LesKaribous/Karibous-2024-Hardware/ECAD/MainBoard-2024/MainBoard-2024.png

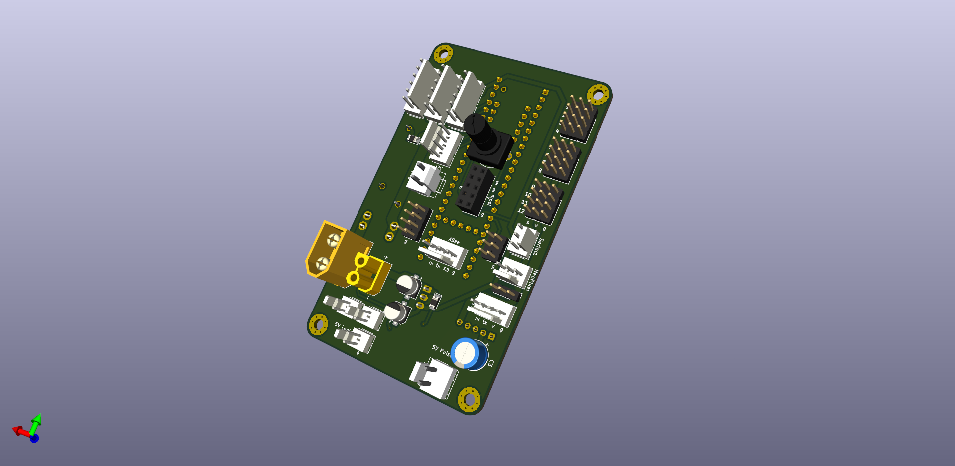
ECAD/MainBoard-2024/MainBoard-2024.png
