LesKaribous/Karibous-2024-Hardware/README.md

# Karibous-2024-Hardware
Hardware du robot des Karibous pour la Coupe de Robotique (Eurobot) 2024
