LesKaribous/Karibous-2024-Hardware/ECAD/MainBoard-2024/Graphics/TopConnectorSilk.png

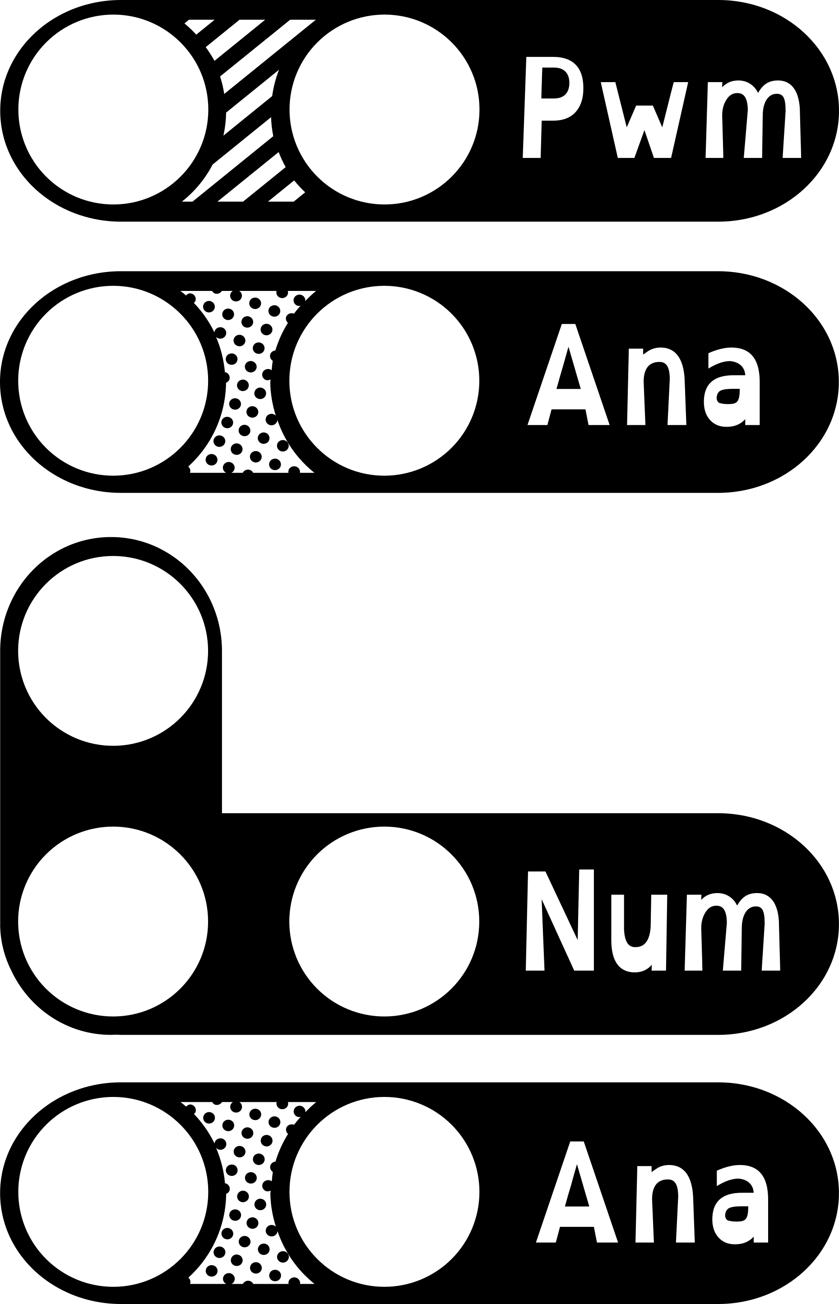
ECAD/MainBoard-2024/Graphics/TopConnectorSilk.png
