LesKaribous/Karibous-2024-Hardware/MCAD/table-parts/visuelDemiTable.png

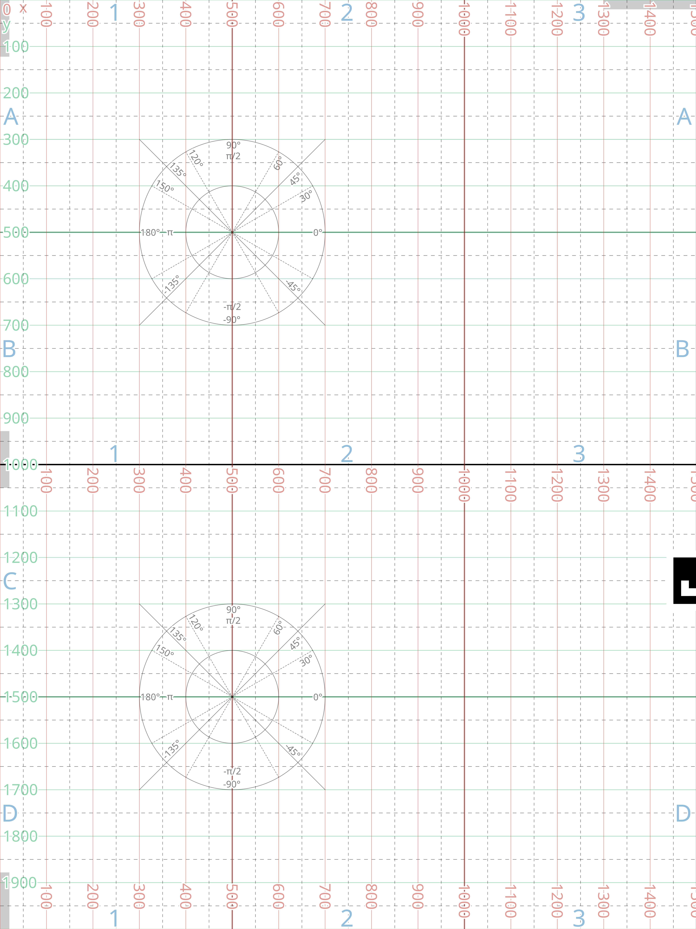
MCAD/table-parts/visuelDemiTable.png
