LesKaribous/Karibous-2024-Hardware/MCAD/table-parts/visuelTable.png

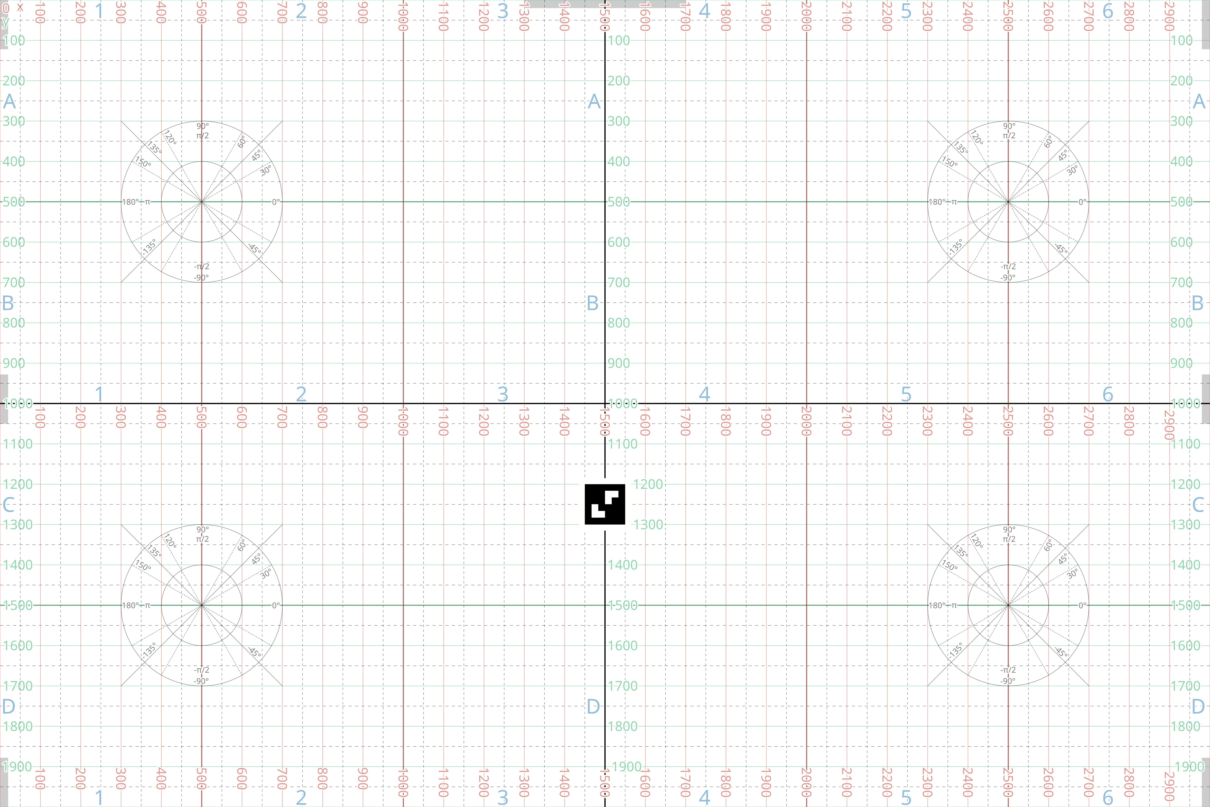
MCAD/table-parts/visuelTable.png
