LesKaribous/Karibous-2024-Hardware/MCAD/actuators-parts/main-actuator.FCStd

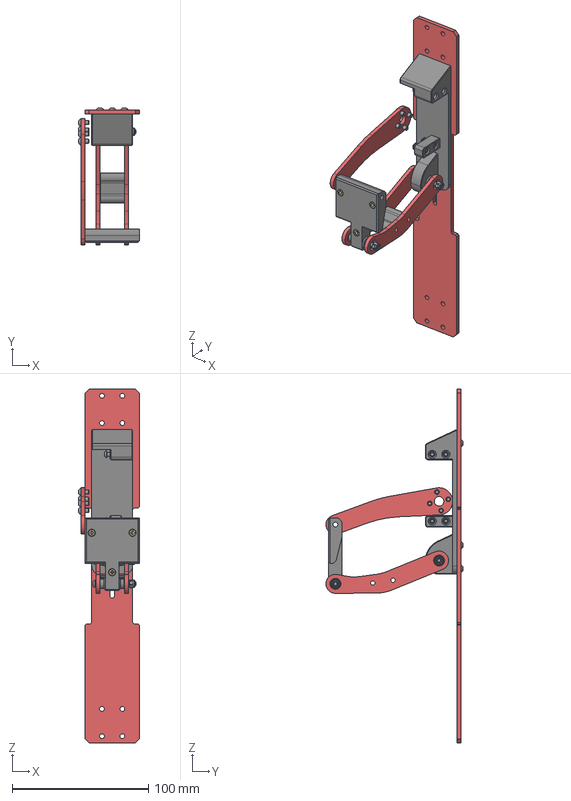
[picture p7: CAD file, 2024-04-19]
MCAD/actuators-parts/main-actuator.FCStd
44.7 x 100.8 x 260.0 mm
MainPlate
BrasInferieur x 2
M3x30-Vis x 2
M3x30-Vis001 x 2
M3-Écrou x 2
M3-Écrou001 x 2
InterBras
SupportPince
M3-Insert252 x 2
M3-Insert253 x 2
M3-Insert254 x 2
M3x6-Vis x 2
M3x6-Vis019 x 2
M3x6-Vis020 x 2
M3x6-Vis021 x 2
BrasServo
BerceauServo
M3x5.74-Insert x 2
M3x5.74-Insert260 x 2
M3x5.74-Insert261 x 2
M3x5.74-Insert262 x 2
M3x5.74-Insert263 x 2
M3x5.74-Insert264 x 2
M3x5.74-Insert265 x 2
M3x5.74-Insert266 x 2
M3x10-Vis x 2
M3x10-Vis584 x 2
M3x10-Vis585 x 2
M3x10-Vis586 x 2
M3x10-Vis599 x 2
M3x10-Vis600 x 2
M3x10-Vis601 x 2
M3x10-Vis602 x 2
