LesKaribous/Karibous-2024-Hardware/ECAD/Ihm-2024/footprints/3d/SW_PUSH-12mm.STEP

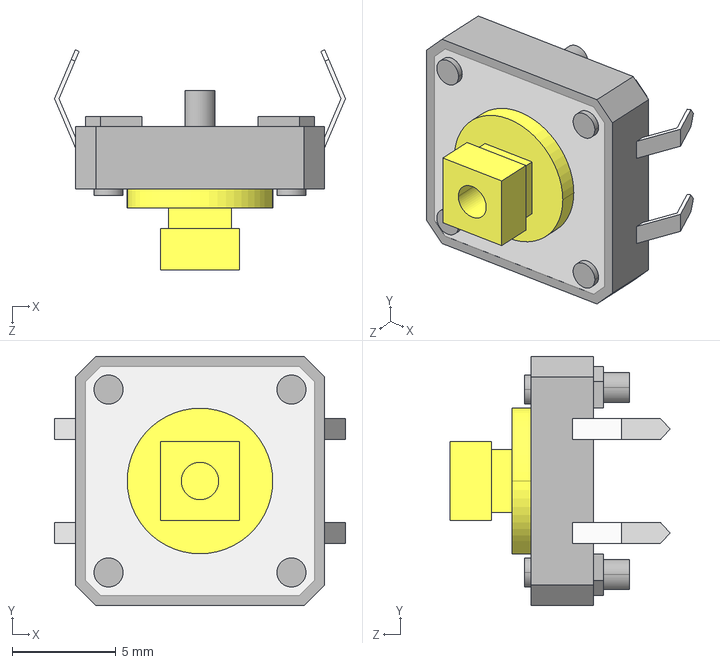
[picture p8: CAD file, 2023-06-12]
ECAD/Ihm-2024/footprints/3d/SW_PUSH-12mm.STEP
14.0 x 12.0 x 10.6 mm
