LesKaribous/Karibous-2024-Hardware/ECAD/MainBoard-2024/Graphics/TopConnectorSilk.dxf

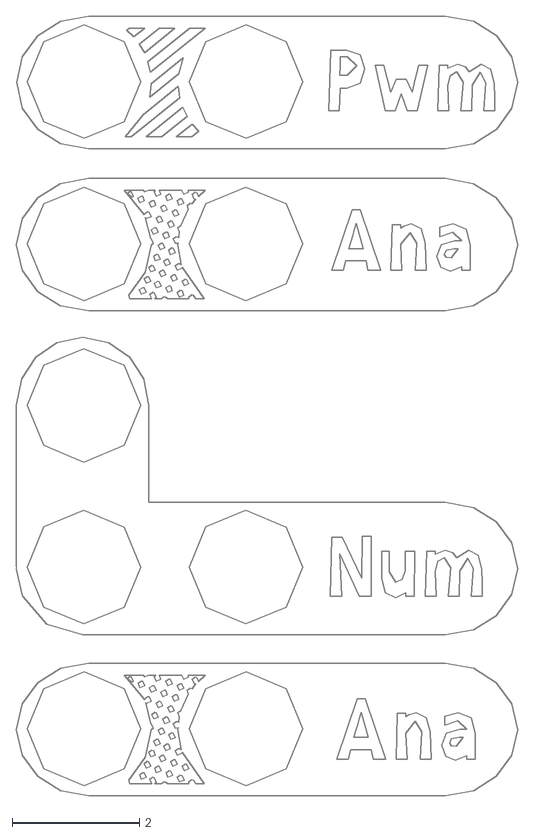
[picture p9: CAD file, 2023-05-28]
ECAD/MainBoard-2024/Graphics/TopConnectorSilk.dxf
7.87 x 12.2
