LesKaribous/Karibous-2024-Hardware/ECAD/MainBoard-2024/Librairies/3d/XT30_Female.stp

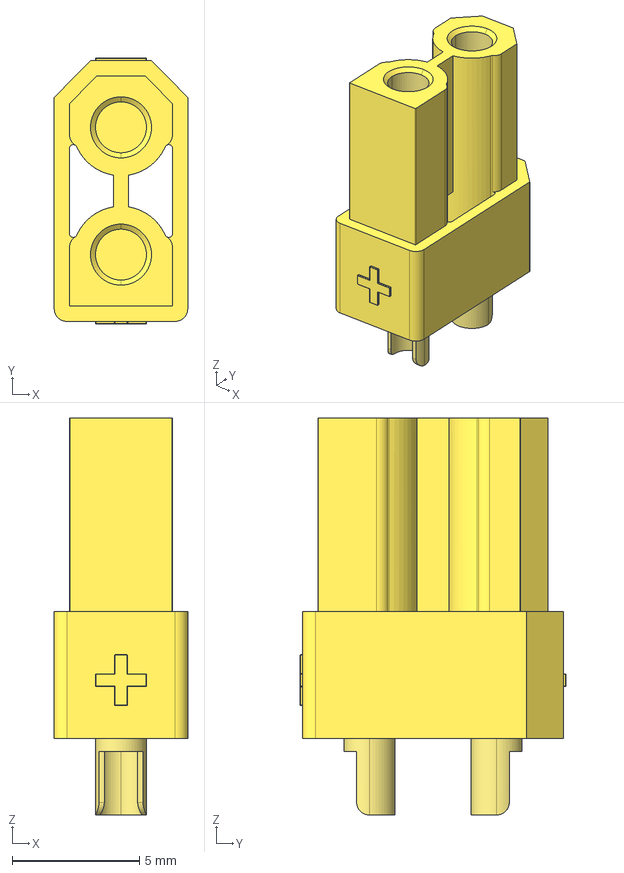
[picture p10: CAD file, 2023-05-28]
ECAD/MainBoard-2024/Librairies/3d/XT30_Female.stp
5.25 x 10.4 x 15.6 mm
