LesKaribous/Karibous-2024-Hardware/ECAD/MainBoard-2024/Librairies/TEN 50-2411/TEN_50-2411.step

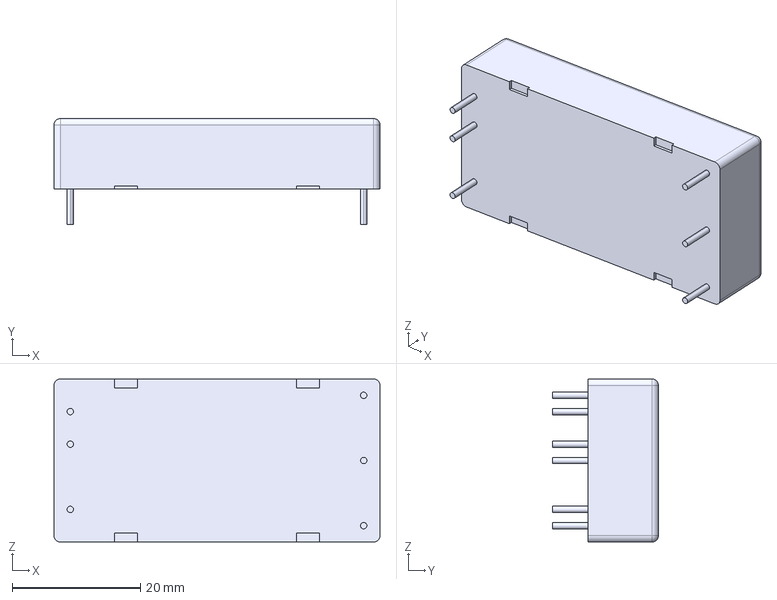
[picture p11: CAD file, 2023-05-28]
ECAD/MainBoard-2024/Librairies/TEN 50-2411/TEN_50-2411.step
50.8 x 16.5 x 25.4 mm
