LesKaribous/Karibous-2024-Hardware/MCAD/3d-print-special/BaliseCylindre.3mf

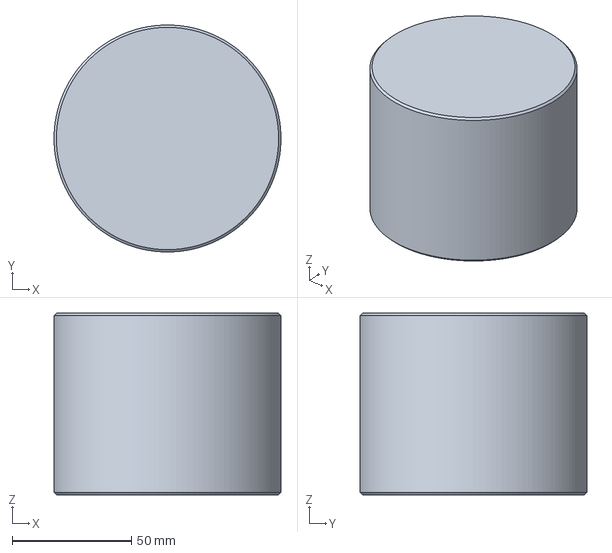
[picture p12: CAD file, 2024-05-01]
MCAD/3d-print-special/BaliseCylindre.3mf
95.0 x 95.0 x 76.0 mm
