LesKaribous/Karibous-2024-Hardware/MCAD/actuators-parts/solar-panel-actuator.FCStd

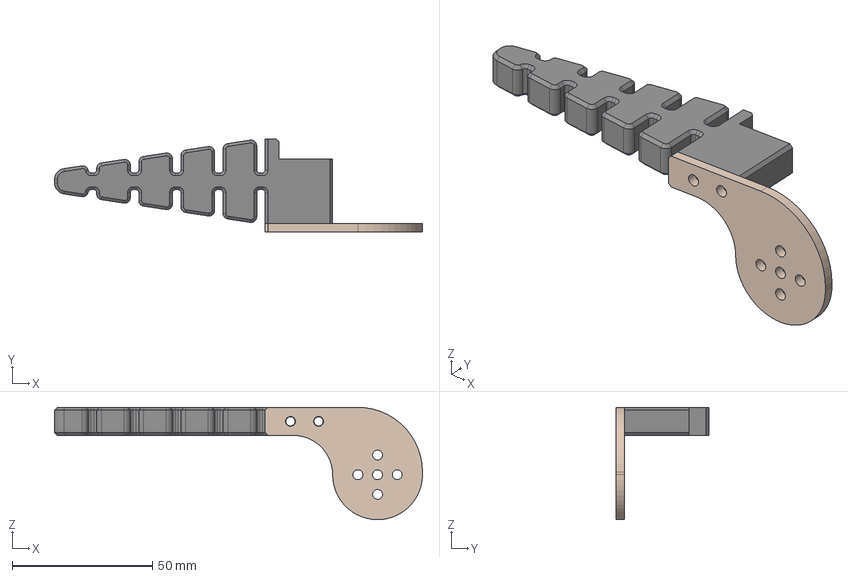
[picture p13: CAD file, 2024-05-04]
MCAD/actuators-parts/solar-panel-actuator.FCStd
131.0 x 33.0 x 40.0 mm
Plate
Finger
