LesKaribous/Karibous-2024-Hardware/MCAD/electronical-parts/deplacement-sensor.FCStd

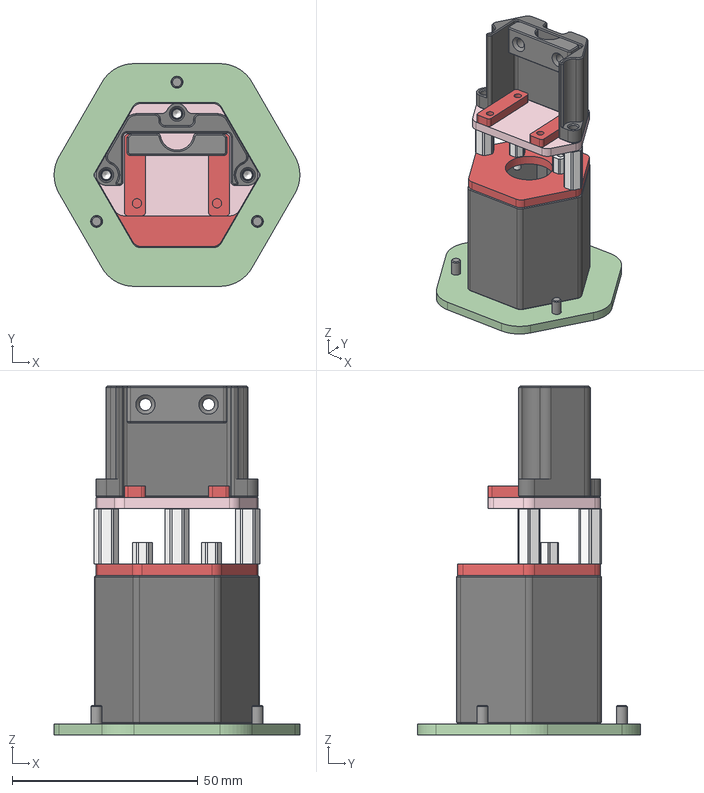
[picture p14: CAD file, 2024-05-06]
MCAD/electronical-parts/deplacement-sensor.FCStd
66.2 x 60.0 x 94.0 mm
SupportPCB
MainTube
FixingPlate
FixingPimori
M2.5x6xx5-Standoff x 2
M2.5x6xx5-Standoff001 x 2
M3x8-Screw x 2
M3x8-Screw039 x 2
M3x8-Screw040 x 2
M3x8-Screw041 x 2
M3x8-Screw042 x 2
M3x8-Screw043 x 2
M3x15xx6-Standoff x 2
M3x15xx6-Standoff013 x 2
M3x15xx6-Standoff014 x 2
FixingBNO055
SpacerBNO055
BrideCable
