LesKaribous/Karibous-2024-Hardware/MCAD/mechanical-parts/colonne-moteur.FCStd

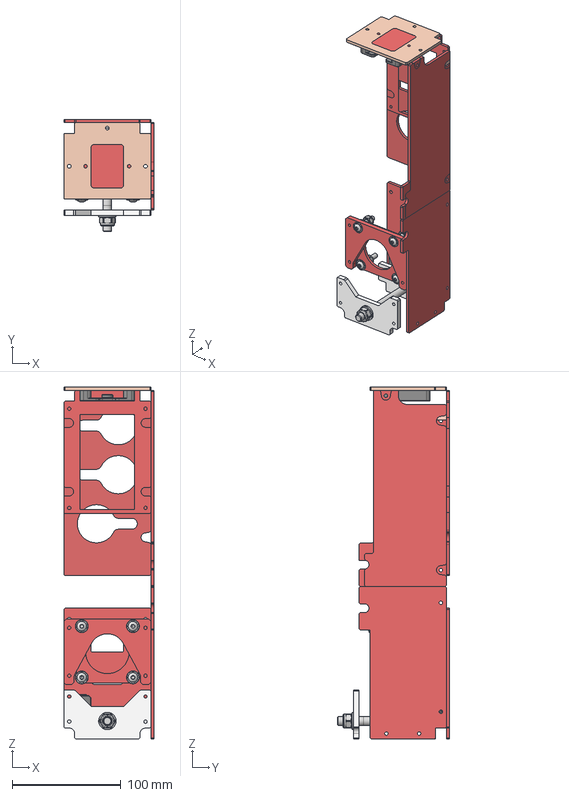
[picture p15: CAD file, 2024-05-06]
MCAD/mechanical-parts/colonne-moteur.FCStd
83.0 x 103.0 x 323.0 mm
CarterMoteur
PlaqueExterneSupportRoue
M8x90-Screw
RondelleLaser3mm
PlaqueInterneSupportRoue
M8-Nut
M8-Washer
SupportMoteur3mm
M5x25-Screw036
M6-Nut
M6-Nut013
M5x25-Screw
M5x25-Screw037
M5x25-Screw038
M6-Nut014
M6-Nut015
SupportMoteur5mm
SupportPololuPOL4079
CarterSup
CarterInf
CarterTop
CarterSide240*320
CarterSupRapid
CarterSupRapideCables
CarterTopXBee
SupportXBee
CarterSupCoteServo
