LesKaribous/Karibous-2024-Hardware/MCAD/robot_holonome.FCStd

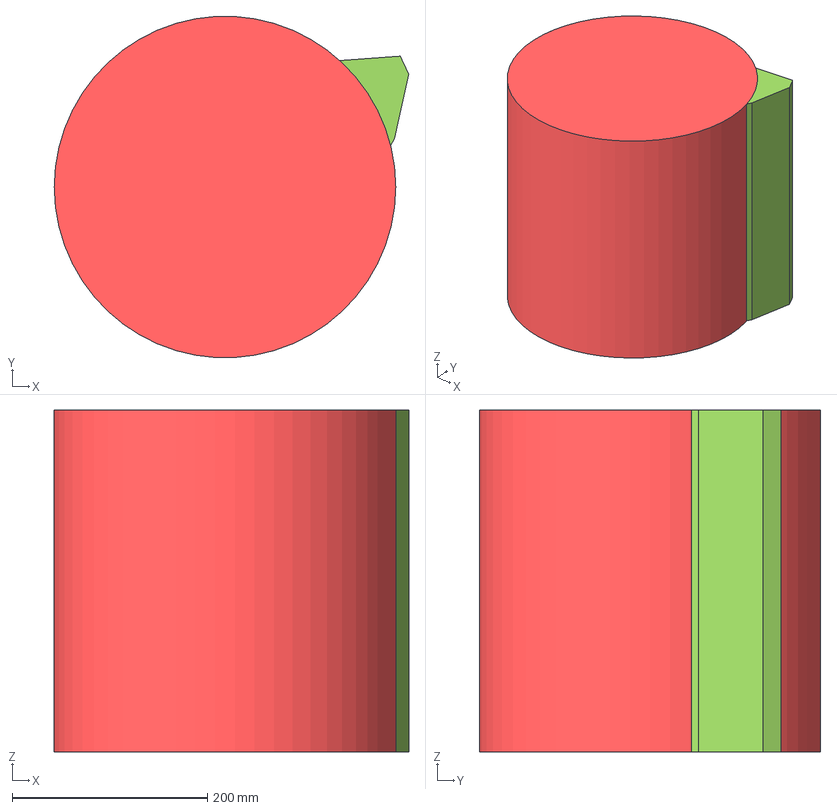
[picture p16: CAD file, 2024-05-06]
MCAD/robot_holonome.FCStd
363.3 x 349.4 x 350.0 mm
Limite Non Déployé
Limite Déployé
Perimètre Déployé
