LesKaribous/Karibous-2024-Hardware/MCAD/table-parts/CoteJardiniere.FCStd

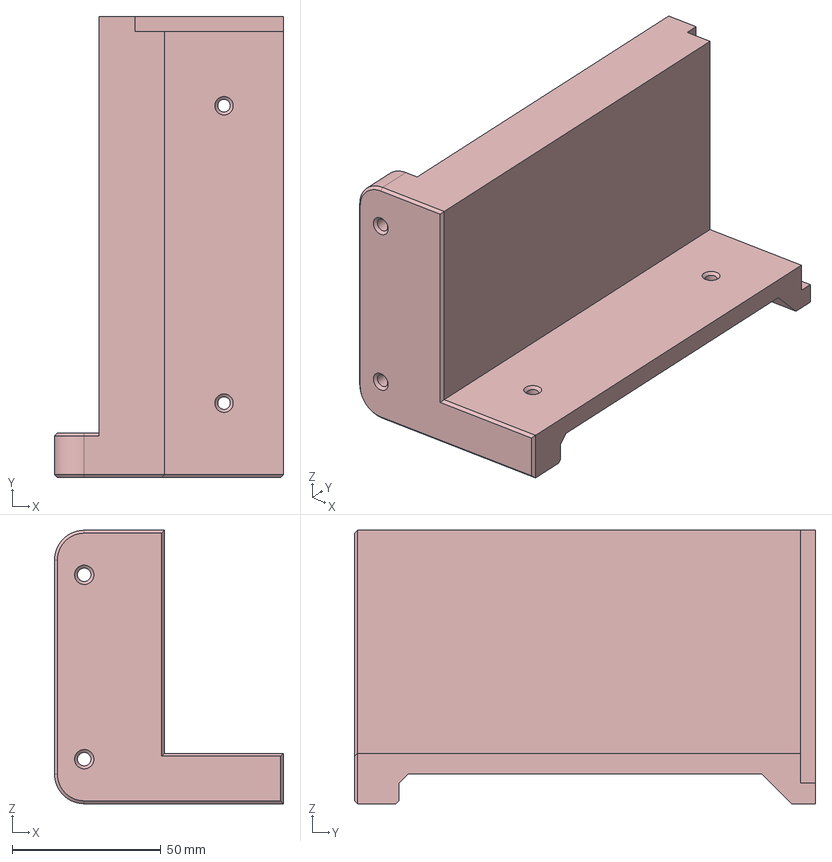
[picture p17: CAD file, 2024-03-27]
MCAD/table-parts/CoteJardiniere.FCStd
77.0 x 155.0 x 92.0 mm
