LesKaribous/Karibous-2024-Hardware/ECAD/Ihm-2024/footprints/3d/SK-12D10.FCStd

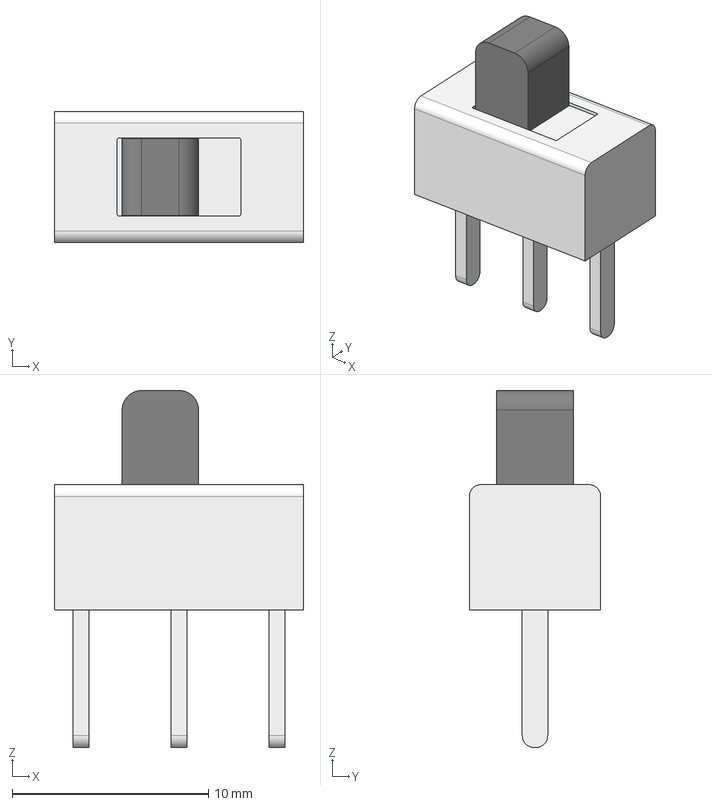
[picture p18: CAD file, 2023-06-12]
ECAD/Ihm-2024/footprints/3d/SK-12D10.FCStd
12.7 x 6.70 x 18.2 mm
Pin
Lever
