LesKaribous/Karibous-2024-Hardware/MCAD/3d-print-special/BaliseHexagone.3mf

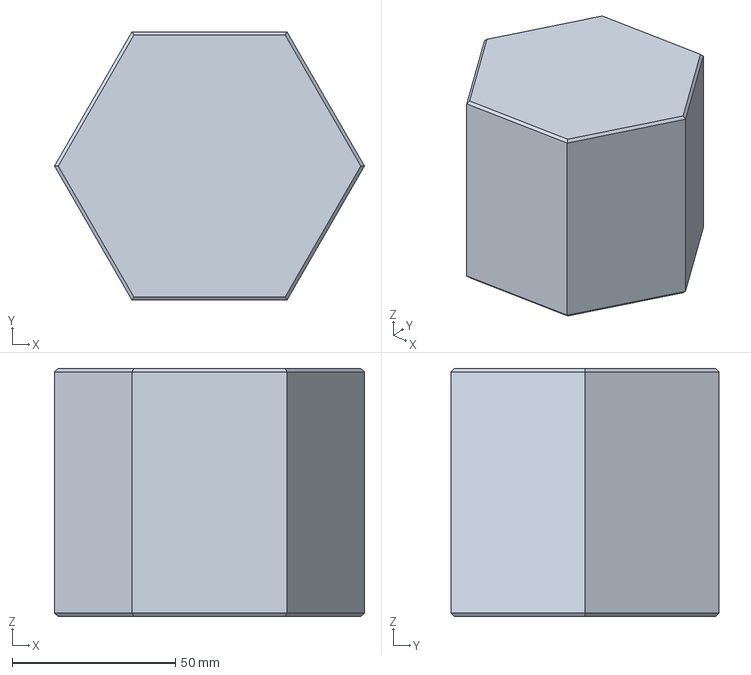
[picture p19: CAD file, 2024-05-01]
MCAD/3d-print-special/BaliseHexagone.3mf
95.0 x 82.3 x 76.0 mm
