LesKaribous/Karibous-2024-Hardware/MCAD/electronical-parts/tiroir_servo.FCStd

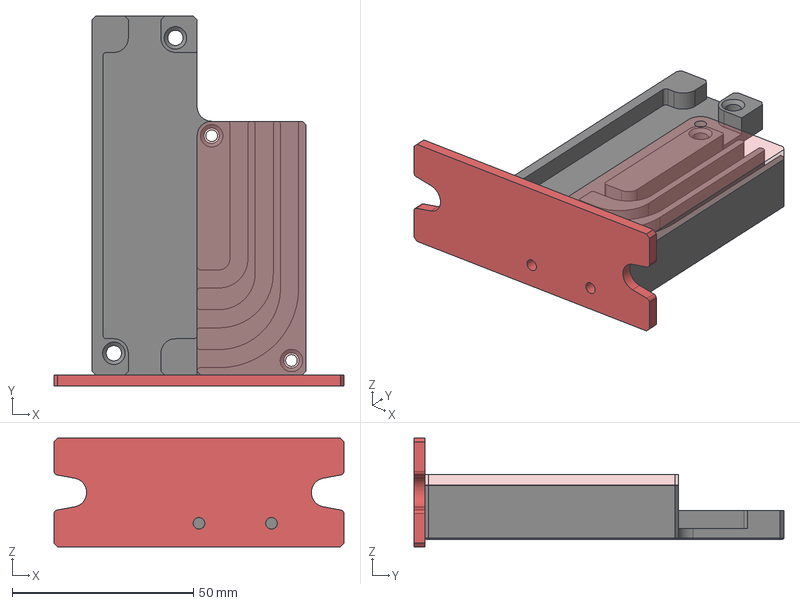
[picture p20: CAD file, 2024-01-14]
MCAD/electronical-parts/tiroir_servo.FCStd
80.0 x 102.0 x 30.0 mm
SupportCarte
FrontServo
CapotServo
