LesKaribous/Karibous-2024-Hardware/MCAD/mechanical-parts/structures.FCStd

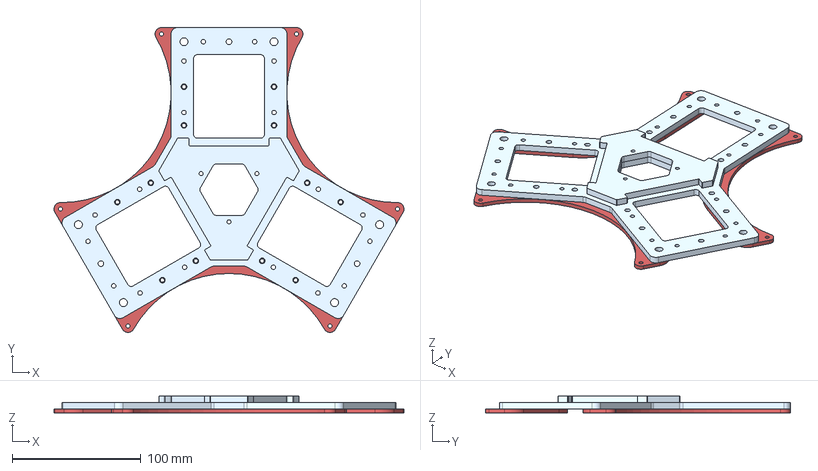
[picture p21: CAD file, 2024-05-06]
MCAD/mechanical-parts/structures.FCStd
272.1 x 237.0 x 13.0 mm
Semelle
CaleCentrale
PlaqueRoulement x 3
