LesKaribous/Karibous-2024-Hardware/MCAD/3d-print-special/BaliseCarre.3mf

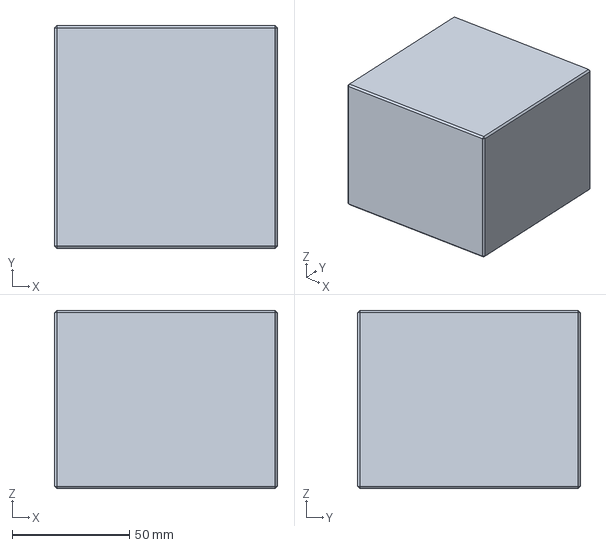
[picture p22: CAD file, 2024-05-01]
MCAD/3d-print-special/BaliseCarre.3mf
95.0 x 95.0 x 76.0 mm
