LesKaribous/Karibous-2024-Hardware/MCAD/actuators-parts/fork-actuator.FCStd

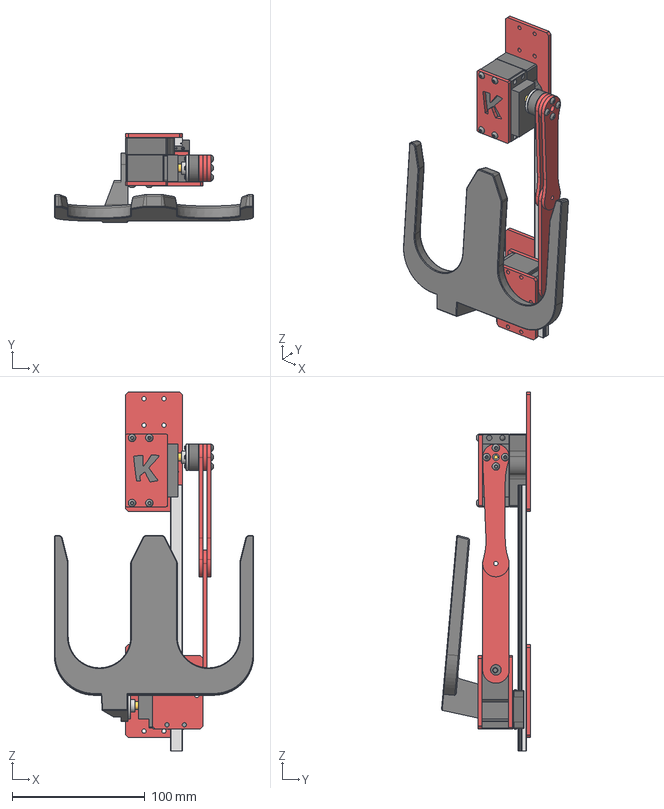
[picture p23: CAD file, 2024-04-19]
MCAD/actuators-parts/fork-actuator.FCStd
150.0 x 66.9 x 270.0 mm
TopArm1 x 2
SpacerArm
TopArm003
SpacerArm1
M3x20-Screw
M3x20-Screw001
M3x20-Screw002
M3x20-Screw003
BlocServo90° x 4
SpacerServo
PlateDeco
M3x10-Screw009 x 2
M3x10-Screw010 x 2
M3x10-Screw011 x 2
M3x10-Screw012 x 2
BottomCarter
TopCarter
RailBody
ServoPalonnier x 2
ServoBody001 x 2
ServoAxis001 x 2
PlaqueGuideCable
InterPlaque5
PlatineSlider
Slider
SupportAxe
Fork
