LesKaribous/Karibous-2024-Hardware/MCAD/mechanical-parts/balises.FCStd

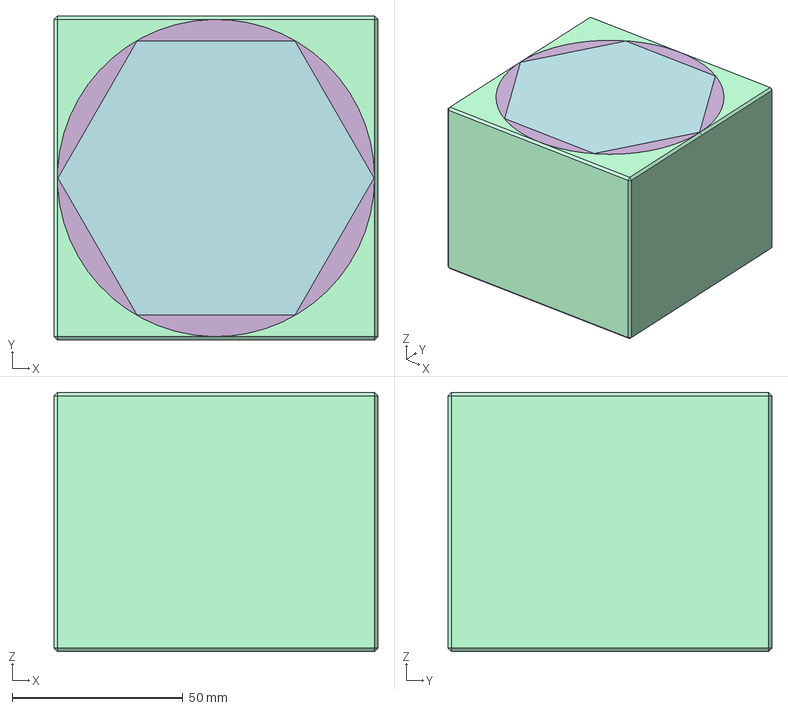
[picture p24: CAD file, 2024-05-01]
MCAD/mechanical-parts/balises.FCStd
95.0 x 95.0 x 76.0 mm
BaliseCarre
BaliseHexagone
BaliseCylindre
