LesKaribous/Karibous-2024-Hardware/MCAD/table_2024.FCStd

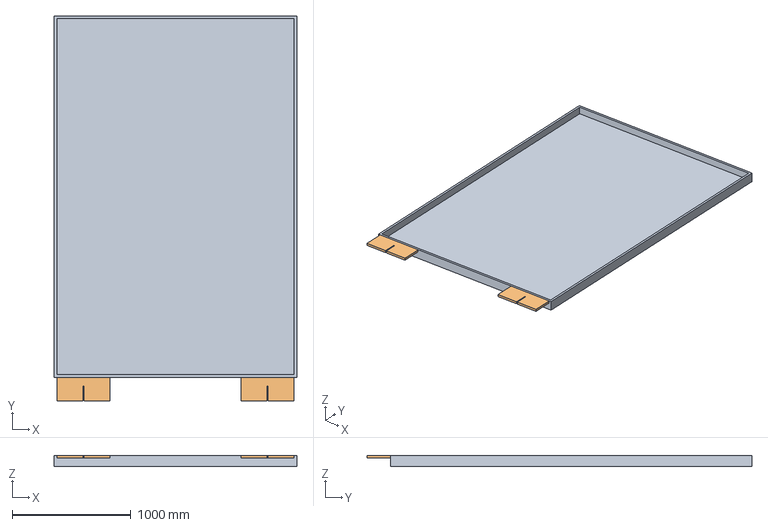
[picture p25: CAD file, 2023-09-15]
MCAD/table_2024.FCStd
2044.0 x 3244.0 x 92.0 mm
BaseTable
SupportVert x 2
