LesKaribous/Karibous-2024-Hardware/MCAD/mechanical-parts/omniwheel.FCStd

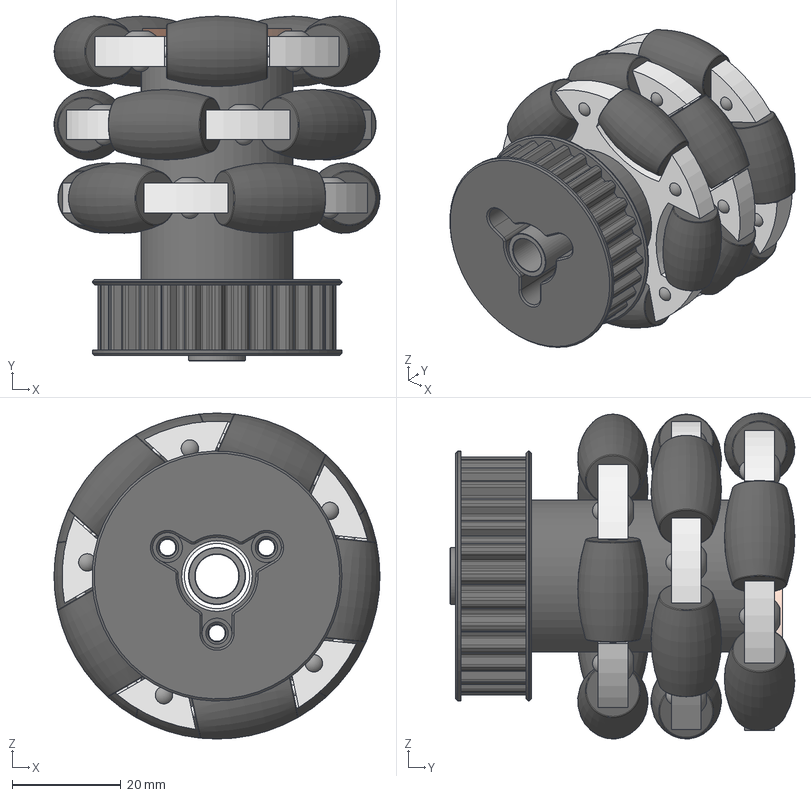
[picture p27: CAD file, 2023-11-20]
MCAD/mechanical-parts/omniwheel.FCStd
60.0 x 63.4 x 60.0 mm
Plate
MainPlate x 3
Roller x 15
Rivet x 15
Spacer001 x 2
Pulley001
Bague 8x10mm
