LesKaribous/Karibous-2024-Hardware/MCAD/actuators-parts/finger-filaflex.FCStd

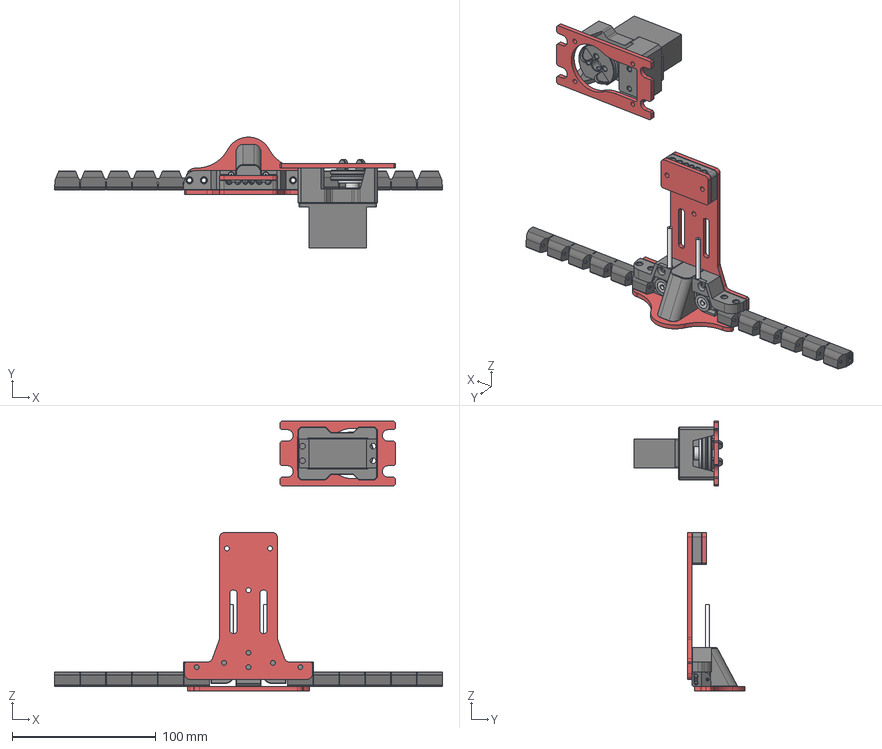
[picture p28: CAD file, 2024-02-26]
MCAD/actuators-parts/finger-filaflex.FCStd
269.6 x 77.0 x 187.5 mm
ServoBody001
ServoAxis001
SupportServo
CliptubeServo
PlaqueServo
ServoPalonnier
Poulie
FingerLeft
SupportFingerLeft
V623ZZ-intern x 2
V623ZZ-extern x 2
ClipTubeLeft
Tube-1ID-3OD x 2
FingerRight
SupportfingerRight
CliptubeRight
SupportCentral
PlaqueCentrale
PlaqueSupport
GestionnaireTube
PlaqueClipGestionnaire
