LesKaribous/Karibous-2024-Hardware/MCAD/mechanical-parts/generic-hardware.FCStd

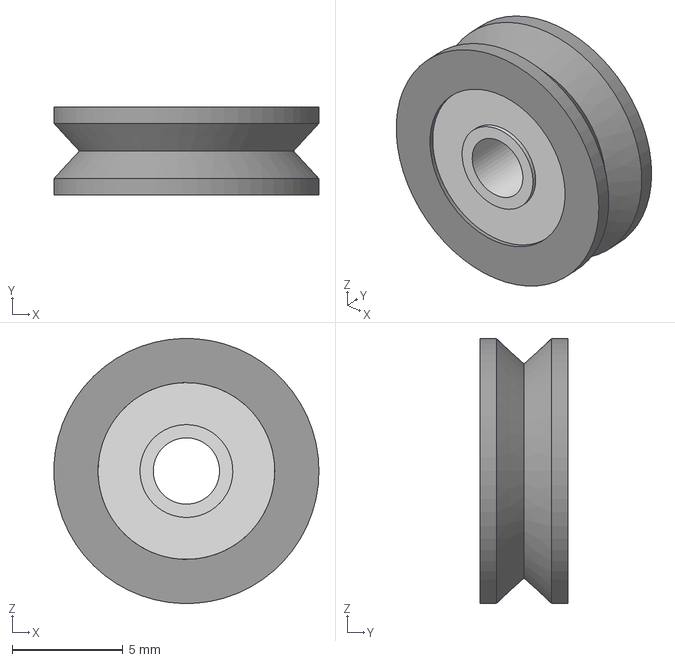
[picture p29: CAD file, 2023-11-20]
MCAD/mechanical-parts/generic-hardware.FCStd
12.0 x 4.00 x 12.0 mm
V623ZZ-intern
V623ZZ-extern
