LesKaribous/Karibous-2024-Hardware/MCAD/actuators-parts/finger-gripper.FCStd

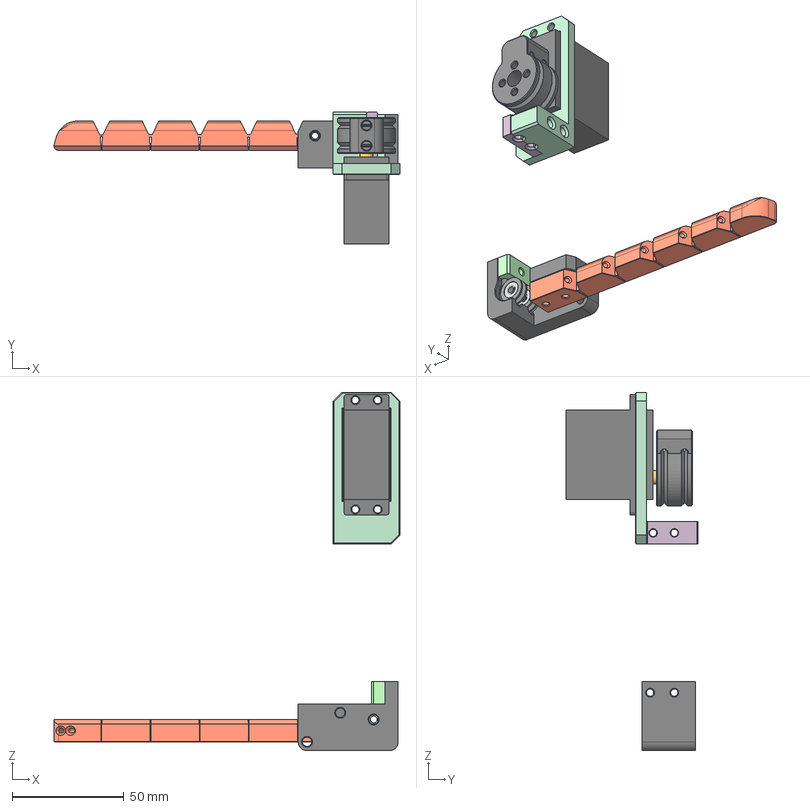
[picture p30: CAD file, 2024-01-02]
MCAD/actuators-parts/finger-gripper.FCStd
155.0 x 59.0 x 160.6 mm
ServoPalonnier
ServoBody001
ServoAxis001
PoulieMoteur
SupportTube
BrideSupportTube
FingerLeft
SupportPoulies
V623ZZ-intern x 2
V623ZZ-extern x 2
Bride
