LesKaribous/Karibous-2024-Hardware/MCAD/mechanical-parts/tools.FCStd

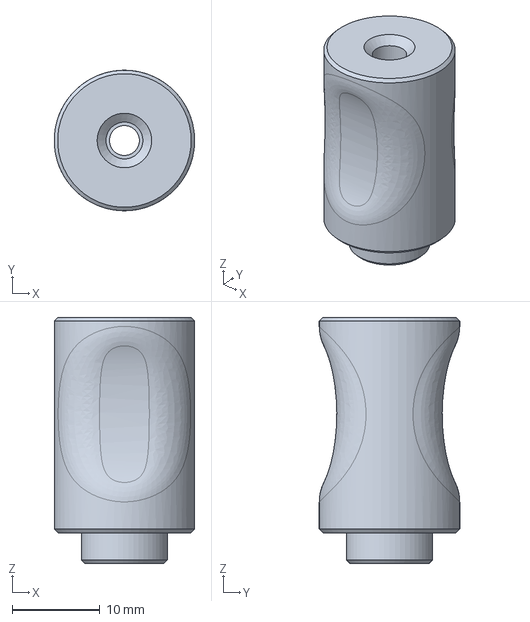
[picture p31: CAD file, 2023-05-29]
MCAD/mechanical-parts/tools.FCStd
16.0 x 16.0 x 28.0 mm
