LesKaribous/Karibous-2024-Hardware/(list of files, cad)

Other CAD files:
ECAD/MainBoard-2024/Librairies/TEN 50-2411/dimensions.FCStd
MCAD/robots_2024.FCStd
ECAD/Ihm-2024/footprints/3d/SK-12D10 1P2T.step
MCAD/actuators-parts/archives/main-actuator-brk.FCStd
