LesKaribous/Karibous-2024-Hardware/ECAD/SatelliteServo-2024/SatelliteServo-2024.kicad_pcb

## KiCad design ECAD/SatelliteServo-2024/SatelliteServo-2024.kicad_pcb (2024-05-09)

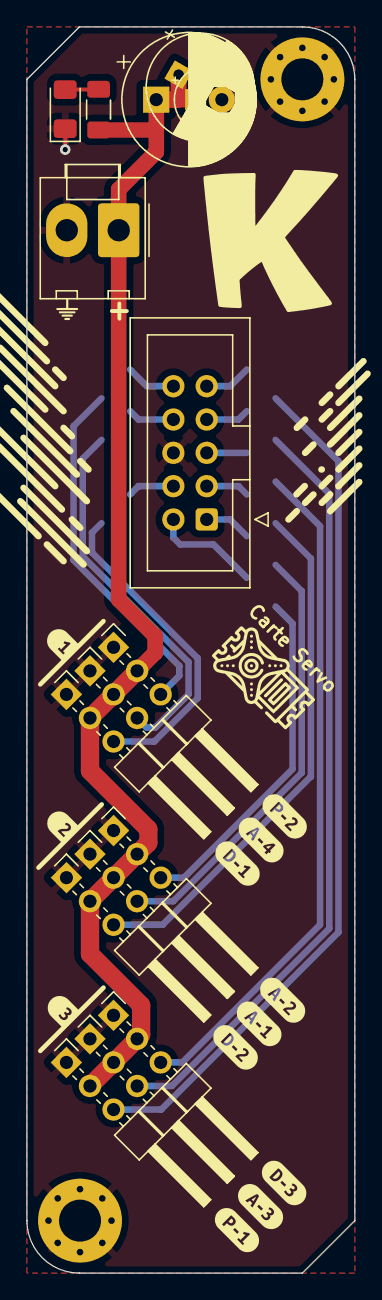
[picture p32: board SatelliteServo-2024.kicad_pcb from above]

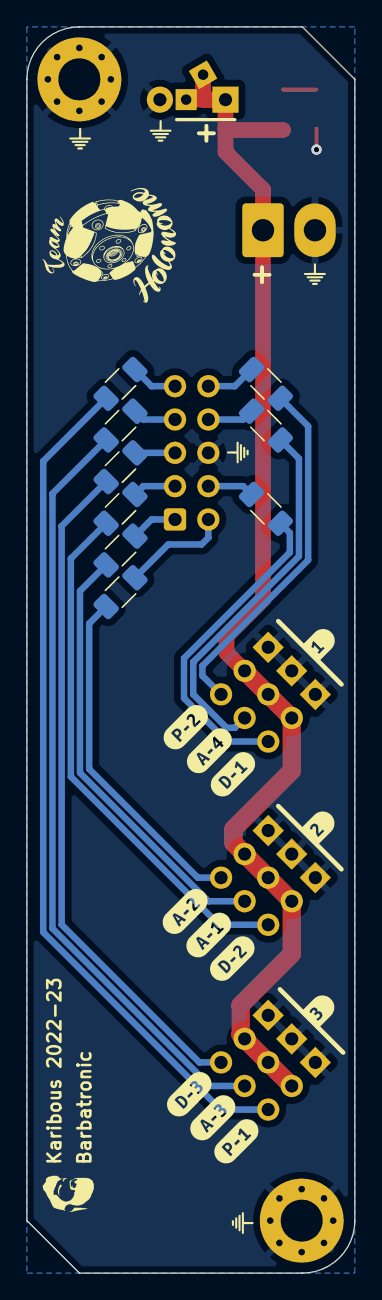
[picture p33: board SatelliteServo-2024.kicad_pcb from below]

Board: 2 copper layers, 25.0 x 95.0 mm, 51 parts (21 on the bottom side), 21 nets.

Parts:
C1: C_Polarized_Small; CP_Radial_D10.0mm_P5.00mm
C2: C_Polarized_Small; CP_Radial_D8.0mm_P3.80mm
C3: C_Polarized_Small; CP_Radial_D5.0mm_P2.00mm
D1: LED_Small; LED_1206_3216Metric_Pad1.42x1.75mm_HandSolder
H1, H2: MountingHole_Pad; MountingHole_3.2mm_M3_Pad_Via
J1: Conn_02x05_Odd_Even; IDC-Header_2x05_P2.54mm_Vertical
J2: Conn_01x02; Molex_KK-396_A-41791-0002_1x02_P3.96mm_Vertical
J3, J4, J5, J6, J7, J8, J9, J10, J11: Conn_01x03; PinHeader_3x01_P2.54mm_Horizontal
R1: R_Small; R_1206_3216Metric_Pad1.30x1.75mm_HandSolder
R2, R3, R4, R5, R6, R7, R8, R9, R10: 220; R_1206_3216Metric_Pad1.30x1.75mm_HandSolder
kibuzzard-634F1A03, kibuzzard-634F1A03#2: G***; kibuzzard-634F1A03
kibuzzard-634F1A09, kibuzzard-634F1A09#2: G***; kibuzzard-634F1A09
kibuzzard-634F1B5B: G***; kibuzzard-634F1B5B
kibuzzard-634F1B38: G***; kibuzzard-634F1B38
kibuzzard-634F1B56: G***; kibuzzard-634F1B56
kibuzzard-634F1BA4: G***; kibuzzard-634F1BA4
kibuzzard-634F1BAB: G***; kibuzzard-634F1BAB
kibuzzard-634F1BB2: G***; kibuzzard-634F1BB2
kibuzzard-634F18D6, kibuzzard-634F18D6#2: G***; kibuzzard-634F18D6
kibuzzard-634F18FE, kibuzzard-634F18FE#2: G***; kibuzzard-634F18FE
kibuzzard-634F19A0, kibuzzard-634F19A0#2: G***; kibuzzard-634F19A0
kibuzzard-634F19A7, kibuzzard-634F19A7#2: G***; kibuzzard-634F19A7
kibuzzard-634F19AD, kibuzzard-634F19AD#2: G***; kibuzzard-634F19AD
kibuzzard-634F19FE, kibuzzard-634F19FE#2: G***; kibuzzard-634F19FE
kibuzzard-634F1907, kibuzzard-634F1907#2: G***; kibuzzard-634F1907

Connections:
+5VP: C1.1, C2.1, C3.1, J2.1, J3.2, J4.2, J5.2, J6.2, J7.2, J8.2, J9.2, J10.2, J11.2, R1.1
GND: C1.2, C2.2, C3.2, D1.1 (K), H1.1, H2.1, J1.6, J2.2, J3.1, J4.1, J5.1, J6.1, J7.1, J8.1, J9.1, J10.1, J11.1
IO_A_1: J1.1, R7.2
IO_A_2: J1.2, R8.2
IO_A_3: J1.7, R9.2
IO_A_4: J1.8, R10.2
IO_D_1: J1.4, R2.2
IO_D_2: J1.3, R3.2
IO_D_3: J1.5, R4.2
IO_P_1: J1.9, R5.2
IO_P_2: J1.10, R6.2
unnamed: D1.2 (A), R1.2
unnamed: J3.3, R2.1
unnamed: J4.3, R3.1
unnamed: J5.3, R4.1
unnamed: J6.3, R7.1
unnamed: J7.3, R5.1
unnamed: J8.3, R6.1
unnamed: J9.3, R8.1
unnamed: J10.3, R9.1
unnamed: J11.3, R10.1
