LesKaribous/Karibous-2024-Hardware/ECAD/TFTAdaptator-2024/TFTAdaptator-2024.kicad_pcb

## KiCad design ECAD/TFTAdaptator-2024/TFTAdaptator-2024.kicad_pcb (2023-09-15)

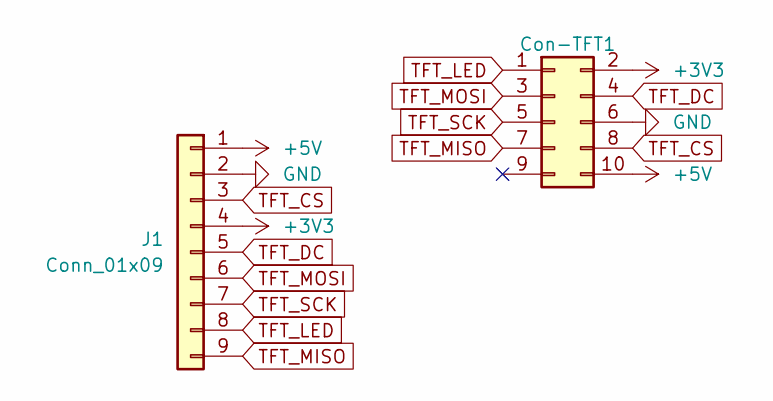
[picture p34: schematic TFTAdaptator-2024.kicad_sch]

Parts:
Con-TFT1: Conn_02x05_Odd_Even; IDC-Header_2x05_P2.54mm_Vertical
J1: Conn_01x09; PinSocket_1x09_P2.54mm_Vertical

Connections:
+3V3: Con-TFT1.2, J1.4
+5V: Con-TFT1.10, J1.1
GND: Con-TFT1.6, J1.2
TFT_CS: Con-TFT1.8, J1.3
TFT_DC: Con-TFT1.4, J1.5
TFT_LED: Con-TFT1.1, J1.8
TFT_MISO: Con-TFT1.7, J1.9
TFT_MOSI: Con-TFT1.3, J1.6
TFT_SCK: Con-TFT1.5, J1.7

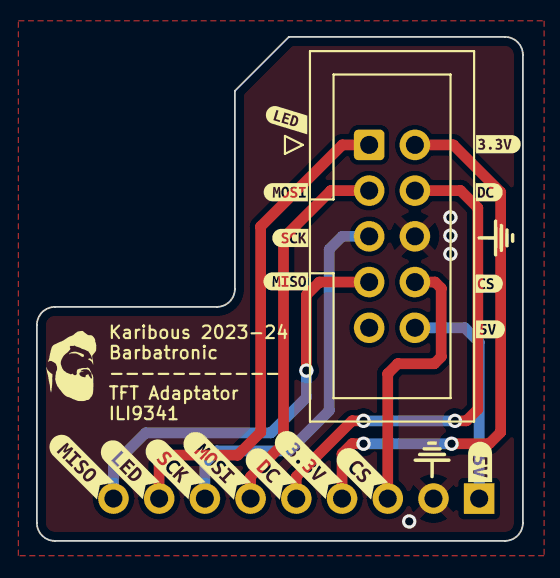
[picture p35: board TFTAdaptator-2024.kicad_pcb from above]

Board: 2 copper layers, 27.0 x 28.0 mm, 18 parts (1 on the bottom side), 9 nets.

Other parts of the board:
kibuzzard-64E9C8A2: G***; kibuzzard-64E9C8A2
kibuzzard-64E9C89C: G***; kibuzzard-64E9C89C
kibuzzard-64E9C866: G***; kibuzzard-64E9C866
kibuzzard-64E9C890: G***; kibuzzard-64E9C890
kibuzzard-64E9C897: G***; kibuzzard-64E9C897
kibuzzard-64E9CBF9: G***; kibuzzard-64E9CBF9
kibuzzard-64E9CDB6: G***; kibuzzard-64E9CDB6
kibuzzard-64E9CDBF: G***; kibuzzard-64E9CDBF
kibuzzard-64E9CDD4: G***; kibuzzard-64E9CDD4
kibuzzard-64E9CDE3: G***; kibuzzard-64E9CDE3
kibuzzard-64E9CE8E: G***; kibuzzard-64E9CE8E
kibuzzard-64E9CE87: G***; kibuzzard-64E9CE87
kibuzzard-64E9CE93: G***; kibuzzard-64E9CE93
kibuzzard-64E9CEBE: G***; kibuzzard-64E9CEBE
kibuzzard-64E9CFC9: G***; kibuzzard-64E9CFC9
kibuzzard-64933136: G***; kibuzzard-64933136
