LesKaribous/Karibous-2024-Hardware/ECAD/MainBoard-2024/MainBoard-2024.kicad_pcb

## KiCad design ECAD/MainBoard-2024/MainBoard-2024.kicad_pcb (2023-08-26)

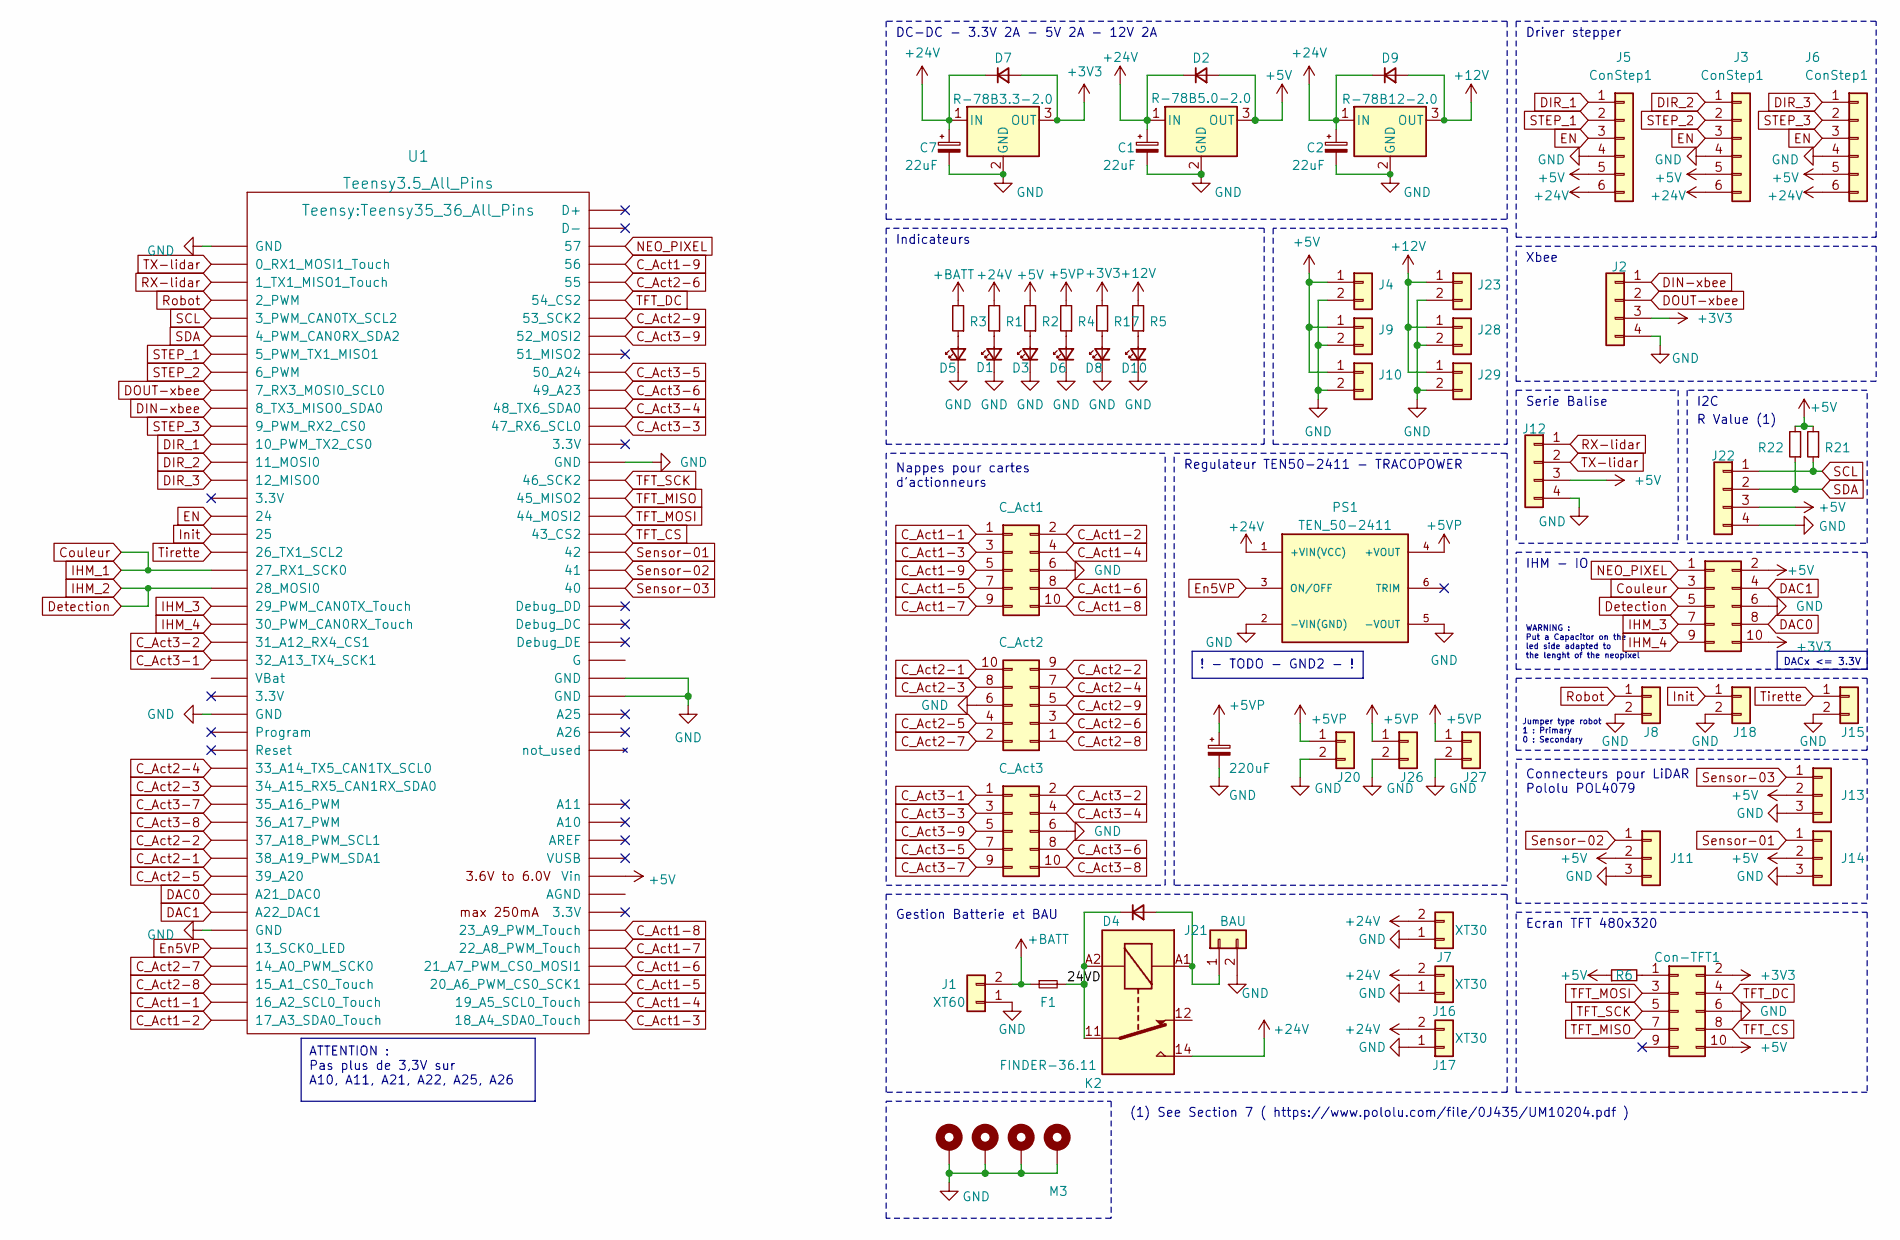
[picture p36: schematic MainBoard-2024.kicad_sch, Main Board 2024]

Parts:
C1, C2, C7: 22uF; CP_Elec_5x5.4
C6: 220uF; CP_Radial_D8.0mm_P3.80mm
C_Act1, C_Act2, C_Act3: Conn_02x05_Odd_Even; IDC-Header_2x05_P2.54mm_Vertical
Con-TFT1: Conn_02x05_Odd_Even; IDC-Header_2x05_P2.54mm_Vertical
D1, D3, D5, D6, D8, D10: LED_Small; LED_1206_3216Metric_Pad1.42x1.75mm_HandSolder
D2, D4, D7, D9: D_Small; D_SMA_Handsoldering
F1: Fuse_Small; Fuseholder_Blade_Mini_Keystone_3568
H1, H2, H3, H4: M3; MountingHole_3.2mm_M3_Pad_Via
IHM-IO1: Conn_02x05_Odd_Even; IDC-Header_2x05_P2.54mm_Vertical
J1: XT60; AMASS_XT60-M_1x02_P7.20mm_Vertical
J2, J12, J22: Conn_01x04; Molex_KK-254_AE-6410-04A_1x04_P2.54mm_Vertical
J3, J5, J6: ConStep1; Molex_KK-254_AE-6410-06A_1x06_P2.54mm_Vertical
J4, J9, J10, J15, J18, J23, J28, J29: Conn_01x02; Molex_KK-254_AE-6410-02A_1x02_P2.54mm_Vertical
J7, J16, J17: XT30; AMASS_XT30U-F_1x02_P5.0mm_Vertical
J8: Conn_01x02; PinHeader_1x02_P2.54mm_Vertical
J11, J13, J14: Conn_01x03; Molex_KK-254_AE-6410-03A_1x03_P2.54mm_Vertical
J20, J21, J26, J27: BAU; Molex_KK-396_A-41791-0002_1x02_P3.96mm_Vertical
K2: FINDER-36.11; Relay_SPDT_Finder_36.11
PS1: TEN_50-2411; CONV_TEN_50-2411; PARTREV February 3, 2021
R1, R2, R3, R4, R5, R6, R17, R21, R22: R_Small; R_1206_3216Metric_Pad1.30x1.75mm_HandSolder
U1: Teensy3.5_All_Pins; Teensy35_36_All_Pins
U2: R-78B3.3-2.0; Converter_DCDC_RECOM_R-78B-2.0_THT
U3: R-78B12-2.0; Converter_DCDC_RECOM_R-78B-2.0_THT
U4: R-78B5.0-2.0; Converter_DCDC_RECOM_R-78B-2.0_THT

Connections:
+3V3: Con-TFT1.2, D7.2 (A), IHM-IO1.10, J2.3, R17.2, U2.3 (OUT)
+5V: Con-TFT1.10, D2.2 (A), IHM-IO1.2, J3.5, J4.1, J5.5, J6.5, J9.1, J10.1, J11.2, J12.3, J13.2, J14.2, J22.3, R2.2, R6.1, R21.2, R22.2, U1.53 (Vin), U4.3 (OUT)
+5VP: C6.1, J20.1, J26.1, J27.1, PS1.4 (+VOUT), R4.2
+12V: D9.2 (A), J23.1, J28.1, J29.1, R5.2, U3.3 (OUT)
+24V: C1.1, C2.1, C7.1, D2.1 (K), D7.1 (K), D9.1 (K), J3.6, J5.6, J6.6, J7.2, J16.2, J17.2, K2.14, PS1.1 (+VIN(VCC)), R1.2, U2.1 (IN), U3.1 (IN), U4.1 (IN)
+BATT: F1.1, J1.2, R3.2
/24VD: D4.1 (K), F1.2, K2.11, K2.A2
C_Act1-1: C_Act1.1, U1.43 (16_A2_SCL0_Touch)
C_Act1-2: C_Act1.2, U1.44 (17_A3_SDA0_Touch)
C_Act1-3: C_Act1.3, U1.45 (18_A4_SDA0_Touch)
C_Act1-4: C_Act1.4, U1.46 (19_A5_SCL0_Touch)
C_Act1-5: C_Act1.7, U1.47 (20_A6_PWM_CS0_SCK1)
C_Act1-6: C_Act1.8, U1.48 (21_A7_PWM_CS0_MOSI1)
C_Act1-7: C_Act1.9, U1.49 (22_A8_PWM_Touch)
C_Act1-8: C_Act1.10, U1.50 (23_A9_PWM_Touch)
C_Act1-9: C_Act1.5, U1.85 (56)
C_Act2-1: C_Act2.10, U1.35 (38_A19_PWM_SDA1)
C_Act2-2: C_Act2.9, U1.34 (37_A18_PWM_SCL1)
C_Act2-3: C_Act2.8, U1.31 (34_A15_RX5_CAN1RX_SDA0)
C_Act2-4: C_Act2.7, U1.30 (33_A14_TX5_CAN1TX_SCL0)
C_Act2-5: C_Act2.4, U1.36 (39_A20)
C_Act2-6: C_Act2.3, U1.84 (55)
C_Act2-7: C_Act2.2, U1.41 (14_A0_PWM_SCK0)
C_Act2-8: C_Act2.1, U1.42 (15_A1_CS0_Touch)
C_Act2-9: C_Act2.5, U1.82 (53_SCK2)
C_Act3-1: C_Act3.1, U1.24 (32_A13_TX4_SCK1)
C_Act3-2: C_Act3.2, U1.23 (31_A12_RX4_CS1)
C_Act3-3: C_Act3.3, U1.76 (47_RX6_SCL0)
C_Act3-4: C_Act3.4, U1.77 (48_TX6_SDA0)
C_Act3-5: C_Act3.7, U1.79 (50_A24)
C_Act3-6: C_Act3.8, U1.78 (49_A23)
C_Act3-7: C_Act3.9, U1.32 (35_A16_PWM)
C_Act3-8: C_Act3.10, U1.33 (36_A17_PWM)
C_Act3-9: C_Act3.5, U1.81 (52_MOSI2)
Couleur: IHM-IO1.3, U1.19 (27_RX1_SCK0)
DAC0: IHM-IO1.8, U1.37 (A21_DAC0)
DAC1: IHM-IO1.4, U1.38 (A22_DAC1)
DIN-xbee: J2.1, U1.10 (8_TX3_MISO0_SDA0)
DIR_1: J5.1, U1.12 (10_PWM_TX2_CS0)
DIR_2: J3.1, U1.13 (11_MOSI0)
DIR_3: J6.1, U1.14 (12_MISO0)
DOUT-xbee: J2.2, U1.9 (7_RX3_MOSI0_SCL0)
Detection: IHM-IO1.5, U1.20 (28_MOSI0)
EN: J3.3, J5.3, J6.3, U1.16 (24)
En5VP: PS1.3 (ON/OFF), U1.40 (13_SCK0_LED)
GND: C1.2, C2.2, C6.2, C7.2, C_Act1.6, C_Act2.6, C_Act3.6, Con-TFT1.6, D1.1 (K), D3.1 (K), D5.1 (K), D6.1 (K), D8.1 (K), D10.1 (K), H1.1, H2.1, H3.1, H4.1, IHM-IO1.6, J1.1, J2.4, J3.4, J4.2, J5.4, J6.4, J7.1, J8.2, J9.2, J10.2, J11.3, J12.4, J13.3, J14.3, J15.2, J16.1, J17.1, J18.2, J20.2, J21.2, J22.4, J23.2, J26.2, J27.2, J28.2, J29.2, PS1.2 (-VIN(GND)), PS1.5 (-VOUT), U1.1 (GND), U1.27 (GND), U1.39 (GND), U1.61 (GND), U1.62 (GND), U1.74 (GND), U2.2 (GND), U3.2 (GND), U4.2 (GND)
IHM_3: IHM-IO1.7, U1.21 (29_PWM_CAN0TX_Touch)
IHM_4: IHM-IO1.9, U1.22 (30_PWM_CAN0RX_Touch)
Init: J18.1, U1.17 (25)
NEO_PIXEL: IHM-IO1.1, U1.86 (57)
unnamed: Con-TFT1.1, R6.2
unnamed: D1.2 (A), R1.1
unnamed: D3.2 (A), R2.1
unnamed: D4.2 (A), J21.1, K2.A1
unnamed: D5.2 (A), R3.1
unnamed: D6.2 (A), R4.1
unnamed: D8.2 (A), R17.1
unnamed: D10.2 (A), R5.1
RX-lidar: J12.1, U1.3 (1_TX1_MISO1_Touch)
Robot: J8.1, U1.4 (2_PWM)
SCL: J22.1, R21.1, U1.5 (3_PWM_CAN0TX_SCL2)
SDA: J22.2, R22.1, U1.6 (4_PWM_CAN0RX_SDA2)
STEP_1: J5.2, U1.7 (5_PWM_TX1_MISO1)
STEP_2: J3.2, U1.8 (6_PWM)
STEP_3: J6.2, U1.11 (9_PWM_RX2_CS0)
Sensor-01: J14.1, U1.69 (42)
Sensor-02: J11.1, U1.68 (41)
Sensor-03: J13.1, U1.67 (40)
TFT_CS: Con-TFT1.8, U1.70 (43_CS2)
TFT_DC: Con-TFT1.4, U1.83 (54_CS2)
TFT_MISO: Con-TFT1.7, U1.72 (45_MISO2)
TFT_MOSI: Con-TFT1.3, U1.71 (44_MOSI2)
TFT_SCK: Con-TFT1.5, U1.73 (46_SCK2)
TX-lidar: J12.2, U1.2 (0_RX1_MOSI1_Touch)
Tirette: J15.1, U1.18 (26_TX1_SCL2)

Notes on the sheet:
DACx <= 3.3V
ATTENTION : Pas plus de 3,3V sur A10, A11, A21, A22, A25, A26
! - TODO - GND2 - !
Nappes pour cartes d'actionneurs
Gestion Batterie et BAU
WARNING : Put a Capacitor on the led side adapted to the lenght of the neopixel
(1) See Section 7 ( https://www.pololu.com/file/0J435/UM10204.pdf )
Serie Balise
Connecteurs pour LiDAR Pololu POL4079
Jumper type robot 1 : Primary 0 : Secondary
Driver stepper
Xbee
Ecran TFT 480x320
DC-DC - 3.3V 2A - 5V 2A - 12V 2A
R Value (1)
Regulateur TEN50-2411 - TRACOPOWER
Indicateurs
IHM - IO
I2C

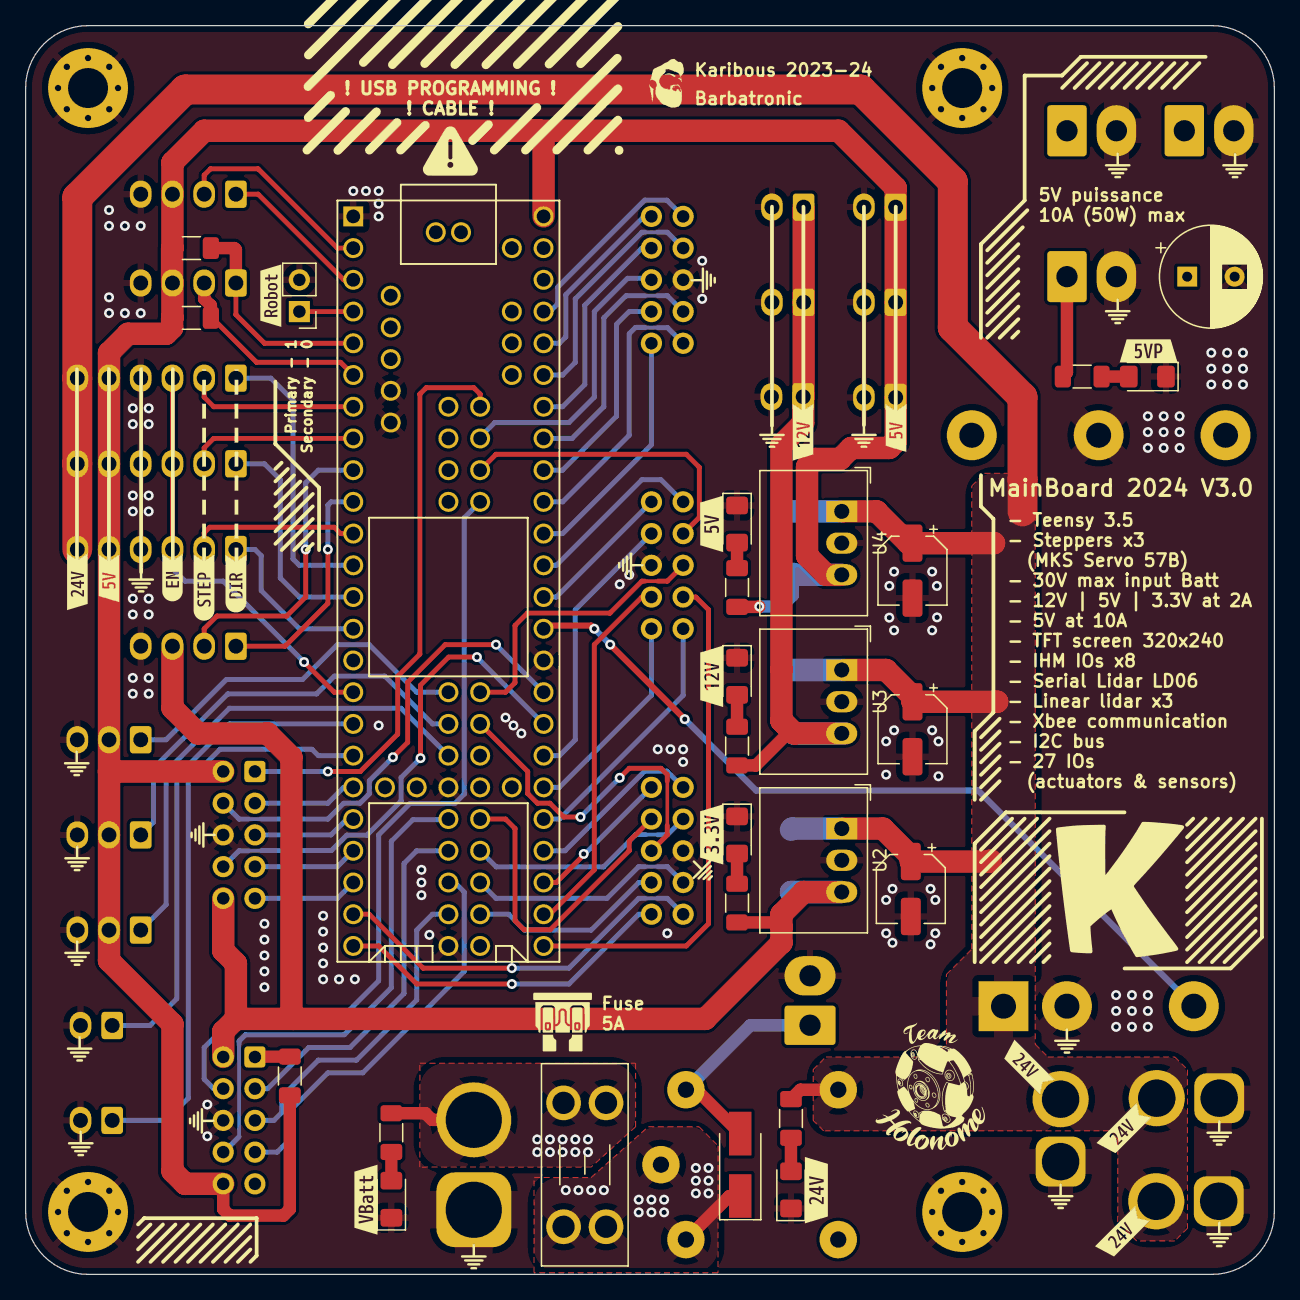
[picture p37: board MainBoard-2024.kicad_pcb from above]

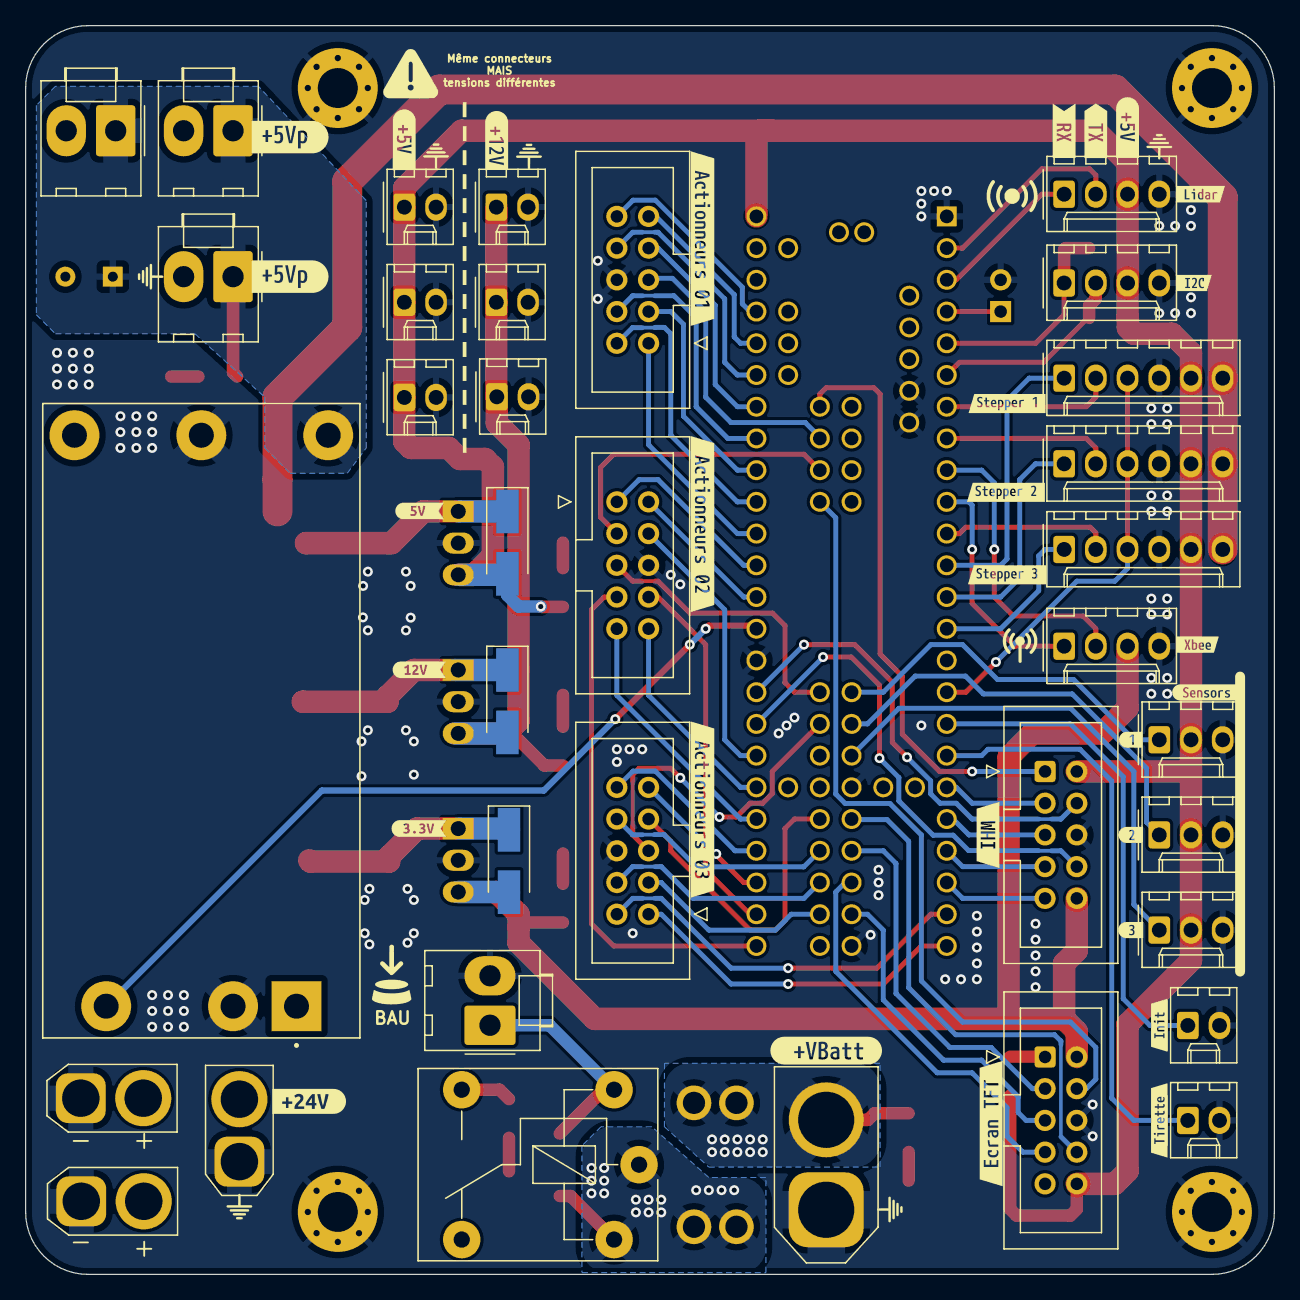
[picture p38: board MainBoard-2024.kicad_pcb from below]

Board: 2 copper layers, 100.0 x 100.0 mm, 111 parts (64 on the bottom side), 75 nets.

Other parts of the board:
kibuzzard-6493EE9E: G***; kibuzzard-6493EE9E
kibuzzard-6493EE40: G***; kibuzzard-6493EE40
kibuzzard-6493EE50: G***; kibuzzard-6493EE50
kibuzzard-6493EE56: G***; kibuzzard-6493EE56
kibuzzard-6493EE83: G***; kibuzzard-6493EE83
kibuzzard-6493EEAC: G***; kibuzzard-6493EEAC
kibuzzard-6493EEE0: G***; kibuzzard-6493EEE0
kibuzzard-6493EEF0: G***; kibuzzard-6493EEF0
kibuzzard-6493EF75: G***; kibuzzard-6493EF75
kibuzzard-6493EFD0: G***; kibuzzard-6493EFD0
kibuzzard-6493EFE7: G***; kibuzzard-6493EFE7
kibuzzard-6493EFEC: G***; kibuzzard-6493EFEC
kibuzzard-6493F0A8: G***; kibuzzard-6493F0A8
kibuzzard-6493F0C8: G***; kibuzzard-6493F0C8
kibuzzard-6493F0E7: G***; kibuzzard-6493F0E7
kibuzzard-6493F09E: G***; kibuzzard-6493F09E
kibuzzard-6493F18B: G***; kibuzzard-6493F18B
kibuzzard-6493F100: G***; kibuzzard-6493F100
kibuzzard-6493F174: G***; kibuzzard-6493F174
kibuzzard-6493F190: G***; kibuzzard-6493F190
kibuzzard-64932E55: G***; kibuzzard-64932E55
kibuzzard-64932EB2, kibuzzard-64932EB2#2: G***; kibuzzard-64932EB2
kibuzzard-64932F6F, kibuzzard-64932F6F#2: G***; kibuzzard-64932F6F
kibuzzard-64944CDF: G***; kibuzzard-64944CDF
kibuzzard-64944CEA: G***; kibuzzard-64944CEA
kibuzzard-64944CF9: G***; kibuzzard-64944CF9
kibuzzard-64944D19, kibuzzard-64944D19#2: G***; kibuzzard-64944D19
kibuzzard-64944D37, kibuzzard-64944D37#2, kibuzzard-64944D37#3, kibuzzard-64944D37#4: G***; kibuzzard-64944D37
kibuzzard-64944DAA: G***; kibuzzard-64944DAA
kibuzzard-649443C2: G***; kibuzzard-649443C2
kibuzzard-649443DA: G***; kibuzzard-649443DA
kibuzzard-649443F6: G***; kibuzzard-649443F6
kibuzzard-6494437E: G***; kibuzzard-6494437E
kibuzzard-6494443F: G***; kibuzzard-6494443F
kibuzzard-64933096: G***; kibuzzard-64933096
kibuzzard-64933122: G***; kibuzzard-64933122
kibuzzard-64933136: G***; kibuzzard-64933136
kibuzzard-64933140: G***; kibuzzard-64933140
kibuzzard-64944345: G***; kibuzzard-64944345
kibuzzard-64944398: G***; kibuzzard-64944398
