LesKaribous/Karibous-2024-Hardware/ECAD/Ihm-2024/Ihm-2024.kicad_pcb

## KiCad design ECAD/Ihm-2024/Ihm-2024.kicad_pcb (2023-07-09)

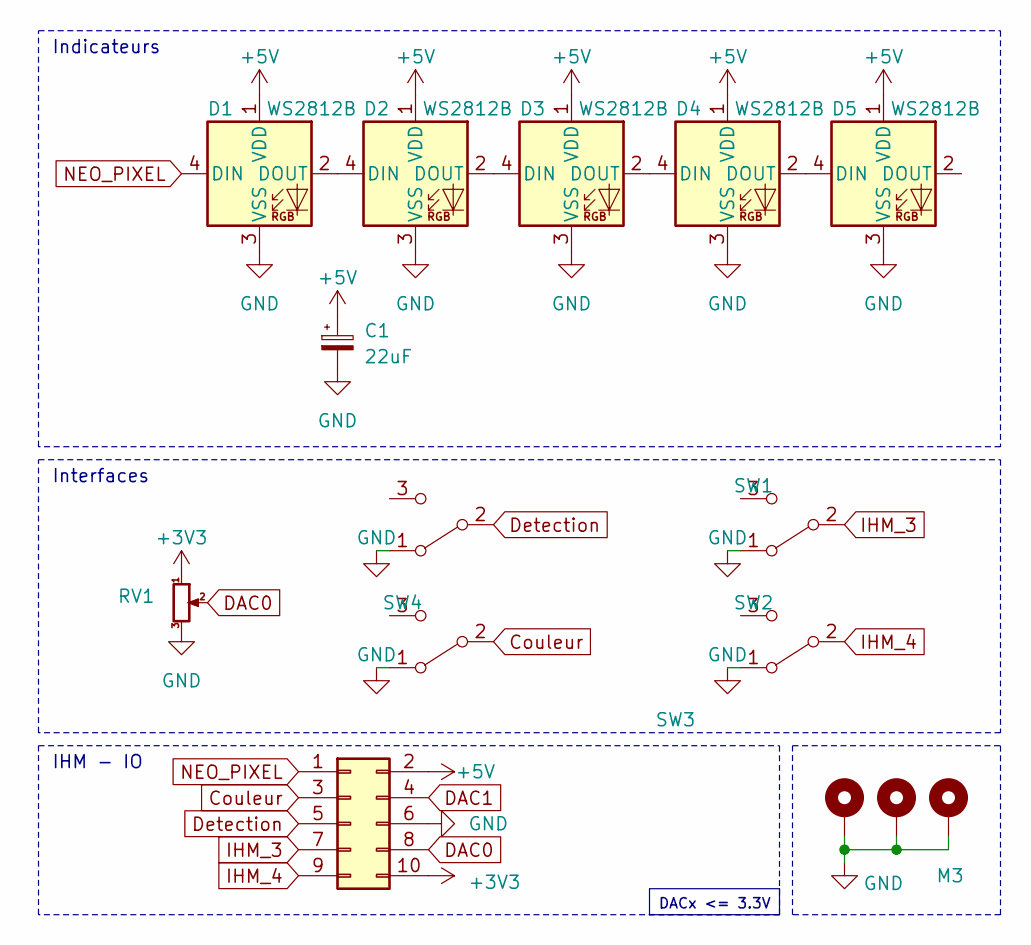
[picture p39: schematic Ihm-2024.kicad_sch]

Parts:
C1: 22uF; CP_Elec_5x5.4
D1, D2, D3, D4, D5: WS2812B; LED_WS2812B_PLCC4_5.0x5.0mm_P3.2mm
H1, H3, H4: M3; MountingHole_3.2mm_M3_Pad_Via
IHM-IO1: Conn_02x05_Odd_Even; IDC-Header_2x05_P2.54mm_Vertical
RV1: R_Potentiometer_Small; Potentiometer_Bourns_PTV09A-1_Single_Vertical
SW1, SW2, SW3, SW4: SW_SPDT; SK-12D10 1P2T

Connections:
+3V3: IHM-IO1.10, RV1.1
+5V: C1.1, D1.1 (VDD), D2.1 (VDD), D3.1 (VDD), D4.1 (VDD), D5.1 (VDD), IHM-IO1.2
Couleur: IHM-IO1.3, SW4.2 (B)
DAC0: IHM-IO1.8, RV1.2
DAC1: IHM-IO1.4
Detection: IHM-IO1.5, SW3.2 (B)
GND: C1.2, D1.3 (VSS), D2.3 (VSS), D3.3 (VSS), D4.3 (VSS), D5.3 (VSS), H1.1, H3.1, H4.1, IHM-IO1.6, RV1.3, SW1.1 (A), SW2.1 (A), SW3.1 (A), SW4.1 (A)
IHM_3: IHM-IO1.7, SW1.2 (B)
IHM_4: IHM-IO1.9, SW2.2 (B)
NEO_PIXEL: D1.4 (DIN), IHM-IO1.1
unnamed: D1.2 (DOUT), D2.4 (DIN)
unnamed: D2.2 (DOUT), D3.4 (DIN)
unnamed: D3.2 (DOUT), D4.4 (DIN)
unnamed: D4.2 (DOUT), D5.4 (DIN)

Notes on the sheet:
DACx <= 3.3V
Interfaces
IHM - IO
Indicateurs

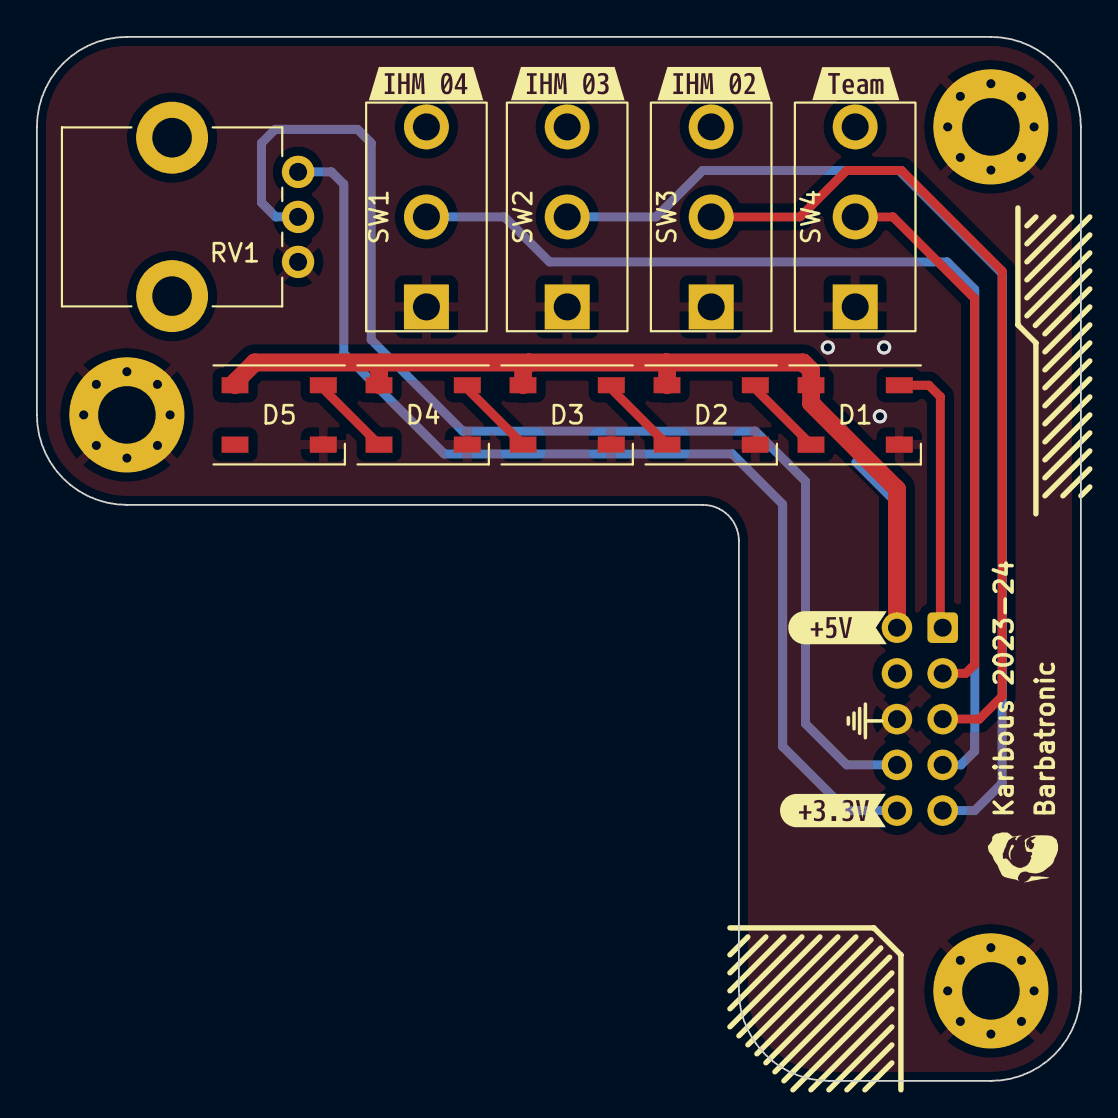
[picture p40: board Ihm-2024.kicad_pcb from above]

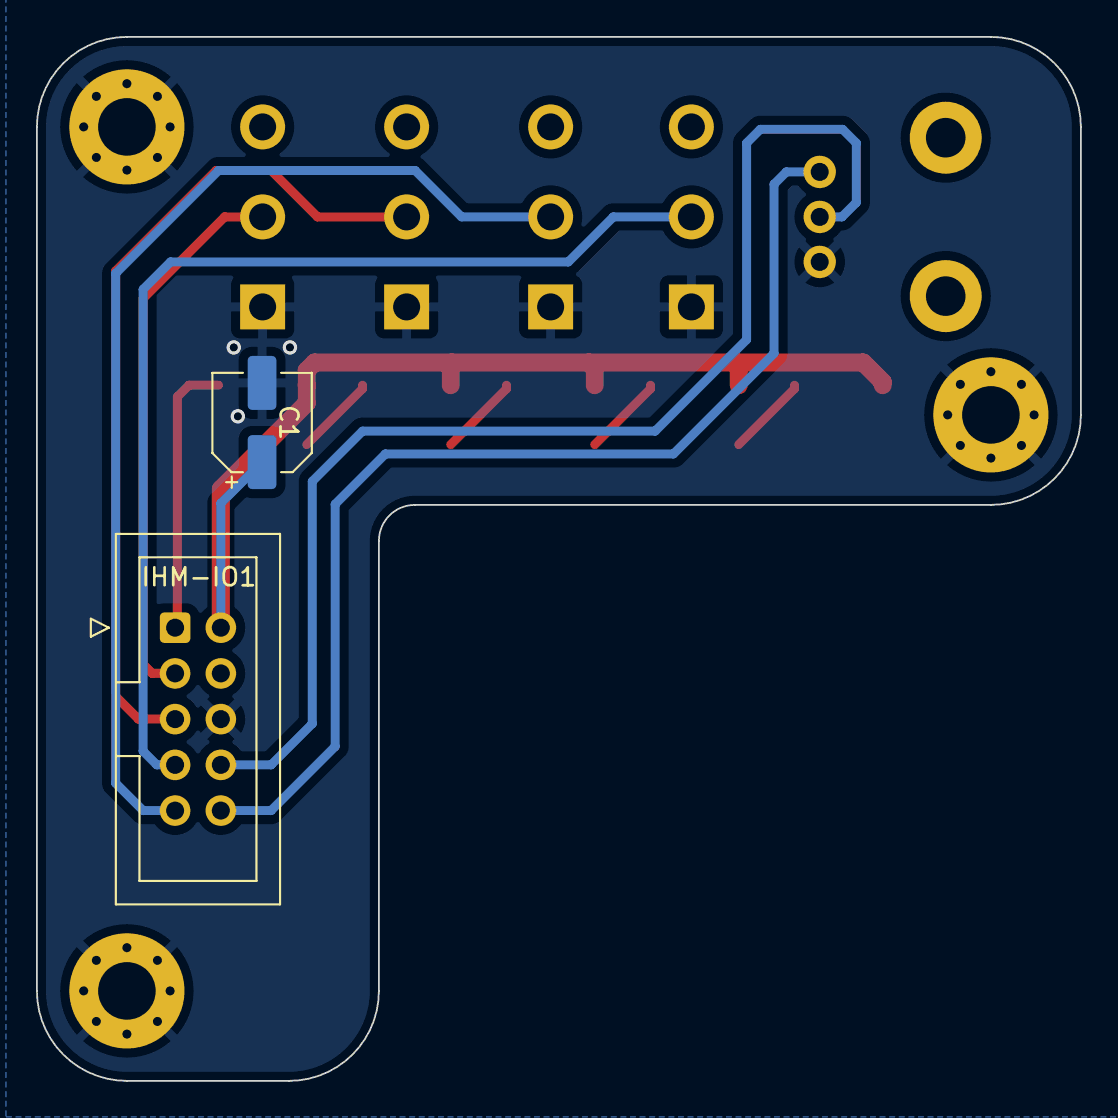
[picture p41: board Ihm-2024.kicad_pcb from below]

Board: 2 copper layers, 58.0 x 58.0 mm, 21 parts (2 on the bottom side), 13 nets.

Other parts of the board:
kibuzzard-64A1DF46: G***; kibuzzard-64A1DF46
kibuzzard-64A1DF73: G***; kibuzzard-64A1DF73
kibuzzard-64A1DFA1: G***; kibuzzard-64A1DFA1
kibuzzard-64A1DFBF: G***; kibuzzard-64A1DFBF
kibuzzard-64A1DFD1: G***; kibuzzard-64A1DFD1
kibuzzard-64A1DFD6: G***; kibuzzard-64A1DFD6
