LesKaribous/Karibous-2024-Hardware/(commit log)

2023-05-28 MainBoard 2023 -> 2024
    [MainBoard-2024-B_Cu.gbr, MainBoard-2024-B_Mask.gbr, MainBoard-2024-B_Paste.gbr, MainBoard-2024-B_Silkscreen.gbr, MainBoard-2024-Edge_Cuts.gbr, MainBoard-2024-F_Cu.gbr, MainBoard-2024-F_Mask.gbr, MainBoard-2024-F_Paste.gbr]
2023-05-29 Clean version MCAD for 2024
    [colonne-moteur.FCStd, deplacement-sensor.FCStd, generic-hardware.FCStd, omniwheel.FCStd, robots_2024.FCStd, structures.FCStd, tools.FCStd]
2023-06-04 change battery box - live 168
    [deplacement-sensor.FCStd, robots_2024.FCStd]
2023-06-08 update component and edge cut
    [MainBoard-2024.kicad_pcb, MainBoard-2024.kicad_sch]
2023-06-10 Simplify + add 12V regul
    [MainBoard-2024.kicad_pcb, MainBoard-2024.kicad_sch]
2023-06-10 change relay
    [MainBoard-2024.kicad_pcb, MainBoard-2024.kicad_sch]
2023-06-11 add ihm features and 12V connectores
    [MainBoard-2024.kicad_pcb, MainBoard-2024.kicad_sch]
2023-06-11 Update 3.3V connectors and placements
    [MainBoard-2024.kicad_pcb, MainBoard-2024.kicad_sch]
2023-06-12 Generate 3D view
    [MainBoard-2024.kicad_pcb]
2023-06-12 MainBoard integration
    [colonne-moteur.FCStd, deplacement-sensor.FCStd, generic-hardware.FCStd, robots_2024.FCStd, table_2024.FCStd]
2023-06-12 Create PCB Ihm
    [Ihm-2024.kicad_pcb, Ihm-2024.kicad_sch, SK-12D10 1P2T.step, SK-12D10.FCStd, SW_PUSH-12mm.STEP]
2023-06-12 Multiple updates
    - Change connectors positions
    - Change Teensy position (for the USB port)
    - Add connector for init button
    - Add 5V signal on the Ihm connecto
    [MainBoard-2024.kicad_pcb]
2023-06-12 Update PCB integration
    - Change mainboard position
    - Add the TFT screen
    - Add the new Ihm PCB
    - Start V2 for Ihm
    - Clean some 2023 components
    [colonne-moteur.FCStd, deplacement-sensor.FCStd, omniwheel.FCStd, structures.FCStd]
2023-06-12 update with PCB
    [robots_2024.FCStd, table_2024.FCStd]
2023-06-12 Re-arrange schematic
    [Ihm-2024.kicad_sch, MainBoard-2024.kicad_sch]
2023-06-14 Apply Aisler DRC 2 layer complex
    [MainBoard-2024.kicad_pcb]
2023-06-14 Apply Aisler DRC 2 layer simple
    [Ihm-2024.kicad_pcb]
2023-06-21 First routing
    [Ihm-2024.kicad_pcb]
2023-06-21 Clean positions
    [MainBoard-2024.kicad_pcb, MainBoard-2024.kicad_sch]
2023-06-21 First test trace
    PCB Trace with poor optimisation and bad width to check the board before final trace.
    [MainBoard-2024.kicad_pcb, MainBoard-2024.kicad_sch]
2023-06-21 Power trace routing
    [MainBoard-2024.kicad_pcb, MainBoard-2024.kicad_sch]
2023-06-21 fix trace width on actionneur connector
    [MainBoard-2024.kicad_pcb]
2023-06-21 fix trace width an position on IHM, TFT and side connectors
    [MainBoard-2024.kicad_pcb]
2023-06-21 Fix errors and warnings following DRC
    [MainBoard-2024.kicad_pcb]
2023-06-21 First silkscreen labels
    [MainBoard-2024.kicad_pcb]
2023-06-22 Complete Bottom Silkscreen
    [MainBoard-2024.kicad_pcb]
2023-06-22 update ICD connector
    [Ihm-2024.kicad_pcb, Ihm-2024.kicad_sch]
2023-06-22 Update Silkscreen
    [MainBoard-2024.kicad_pcb]
2023-06-22 add capacitor
    [Ihm-2024.kicad_pcb, Ihm-2024.kicad_sch]
2023-07-09 Live 170 - Carter IHM and TFT
    [colonne-moteur.FCStd, deplacement-sensor.FCStd, robots_2024.FCStd, table_2024.FCStd]
2023-07-19 update battery cables and rapid carter
    [colonne-moteur.FCStd, deplacement-sensor.FCStd, robot_holonome.FCStd, robots_2024.FCStd, structures.FCStd, table_2024.FCStd]
2023-07-22 fix recom 78b05 orientation
    [MainBoard-2024.kicad_pcb, MainBoard-2024.kicad_sch]
2023-08-02 fix gap on recom - Add vias
    [MainBoard-2024.kicad_pcb]
2023-08-02 fix nametag and vias before aisler order
    [MainBoard-2024.kicad_pcb]
2023-08-26 create TFT adaptator PCB
    [TFTAdaptator-2024.kicad_pcb, TFTAdaptator-2024.kicad_sch]
2023-08-26 update silkscreen, dimensions and DRC
    [TFTAdaptator-2024.kicad_pcb]
2023-08-26 minor fix
    [colonne-moteur.FCStd, deplacement-sensor.FCStd, robot_holonome.FCStd, robots_2024.FCStd, table_2024.FCStd]
2023-08-26 change resistor value
    [MainBoard-2024.kicad_sch]
2023-08-26 clean repo
    Nettoyage du repo. La branche "backup-clean" a été créée pour conserver l'historique.
    [familylist_refdes.csv]
2023-09-15 create PAMI
    [generic-hardware.FCStd, motorisation-pami.FCStd, pami_2024.FCStd, structure-pami.FCStd]
2023-09-15 fix visual
    [deplacement-sensor.FCStd, robot_holonome.FCStd, robots_2024.FCStd, table_2024.FCStd]
2023-09-15 add silkscreen
    [TFTAdaptator-2024.kicad_pcb]
2023-09-19 add BAU
    [motorisation-pami.FCStd, pami_2024.FCStd]
2023-09-21 move PAMI to another repo
    [motorisation-pami.FCStd, pami_2024.FCStd, structure-pami.FCStd]
2023-09-23 Add 623zz
    [generic-hardware.FCStd]
2023-10-20 Add vinyle and 2024 elements
    [colonne-moteur.FCStd, deplacement-sensor.FCStd, robot_holonome.FCStd, robots_2024.FCStd]
2023-11-02 Add actuators
    [deplacement-sensor.FCStd, generic-hardware.FCStd, main-actuator.FCStd, omniwheel.FCStd, robot_holonome.FCStd, robots_2024.FCStd, structures.FCStd]
2023-11-02 add skeleton
    [main-actuator.FCStd]
2023-11-03 create actuators arms
    [colonne-moteur.FCStd, deplacement-sensor.FCStd, generic-hardware.FCStd, main-actuator.FCStd, robot_holonome.FCStd, robots_2024.FCStd]
2023-11-03 Add gripper on main actuators
    [colonne-moteur.FCStd, deplacement-sensor.FCStd, main-actuator.FCStd, robot_holonome.FCStd, robots_2024.FCStd]
2023-11-05 update proto actuator - live 180
    [colonne-moteur.FCStd, deplacement-sensor.FCStd, main-actuator.FCStd, robot_holonome.FCStd, robots_2024.FCStd]
2023-11-20 testing new gripper
    [colonne-moteur.FCStd, deplacement-sensor.FCStd, finger-gripper.FCStd, generic-hardware.FCStd, main-actuator.FCStd, omniwheel.FCStd, robot_holonome.FCStd, robots_2024.FCStd]
2023-11-22 new bride gripper
    [colonne-moteur.FCStd, deplacement-sensor.FCStd, finger-gripper.FCStd, main-actuator.FCStd, robot_holonome.FCStd, robots_2024.FCStd]
2023-11-22 add fixations holes
    [finger-gripper.FCStd, main-actuator.FCStd]
2023-11-27 new test gripper
    [colonne-moteur.FCStd, deplacement-sensor.FCStd, finger-gripper.FCStd, main-actuator.FCStd, robot_holonome.FCStd, robots_2024.FCStd]
2024-01-02 archive the older actuator
    [main-actuator-brk.FCStd]
2024-01-02 clean and archive
    [finger-gripper.FCStd]
2024-01-02 new filaflex version
    [finger-filaflex.FCStd]
2024-01-02 clean, update and add flex actuator
    [main-actuator.FCStd]
2024-01-02 add new flex actuator and update perimeter
    [robot_holonome.FCStd, robots_2024.FCStd]
2024-01-02 nan
    Silly weird thing about update a complex file in freecad :D nothing to see here...
    [colonne-moteur.FCStd, deplacement-sensor.FCStd]
2024-01-02 add tubing gest
    [colonne-moteur.FCStd, deplacement-sensor.FCStd, finger-filaflex.FCStd, main-actuator.FCStd, robot_holonome.FCStd, robots_2024.FCStd]
2024-01-14 add PCB Servo
    [deplacement-sensor.FCStd, main-actuator.FCStd, robot_holonome.FCStd, robots_2024.FCStd, tiroir_servo.FCStd]
2024-02-26 update battery clip and handle
    [deplacement-sensor.FCStd]
2024-02-26 add Cable management for charging and programming
    [deplacement-sensor.FCStd, robot_holonome.FCStd]
2024-02-27 upgrade Xbee support
    [colonne-moteur.FCStd, deplacement-sensor.FCStd, robot_holonome.FCStd, robots_2024.FCStd, structures.FCStd]
2024-03-27 update hardware robot and table
    [CoteJardiniere.FCStd, colonne-moteur.FCStd, deplacement-sensor.FCStd, main-actuator.FCStd, robot_holonome.FCStd, robots_2024.FCStd, structures.FCStd]
2024-04-14 New Fork Actuators - Go Poseidon !
    [acsenseur.FCStd, colonne-moteur.FCStd, deplacement-sensor.FCStd, fork-actuator.FCStd, main-actuator.FCStd, robot_holonome.FCStd, robots_2024.FCStd, structures.FCStd]
2024-04-19 before Belgium
    [colonne-moteur.FCStd, deplacement-sensor.FCStd, fork-actuator.FCStd, main-actuator.FCStd, robot_holonome.FCStd, robots_2024.FCStd, structures.FCStd]
2024-05-01 add balise ^^
    [BaliseCarre.3mf, BaliseCylindre.3mf, BaliseHexagone.3mf, balises.FCStd]
2024-05-04 New actuator
    [colonne-moteur.FCStd, deplacement-sensor.FCStd, robot_holonome.FCStd, robots_2024.FCStd, solar-panel-actuator.FCStd, structures.FCStd]
2024-05-06 add features on beacon support
    [colonne-moteur.FCStd, deplacement-sensor.FCStd, robot_holonome.FCStd, robots_2024.FCStd, structures.FCStd]
2024-05-06 esthetic updates
    [colonne-moteur.FCStd, robot_holonome.FCStd]
2024-05-09 WIP - new servo 2024 PCB
    [SatelliteServo-2024.kicad_pcb, SatelliteServo-2024.kicad_sch]
